OSHE-Github/RecycleBot/README.md

# OSHE-RecycleBot
<p align="middle">
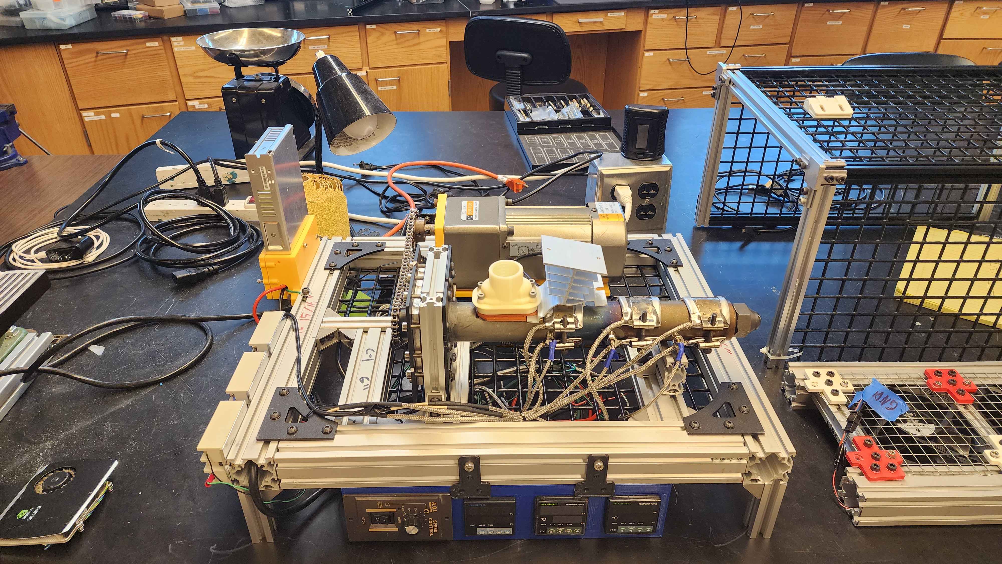
[picture p1: Pictures/Extruder.jpg]
  
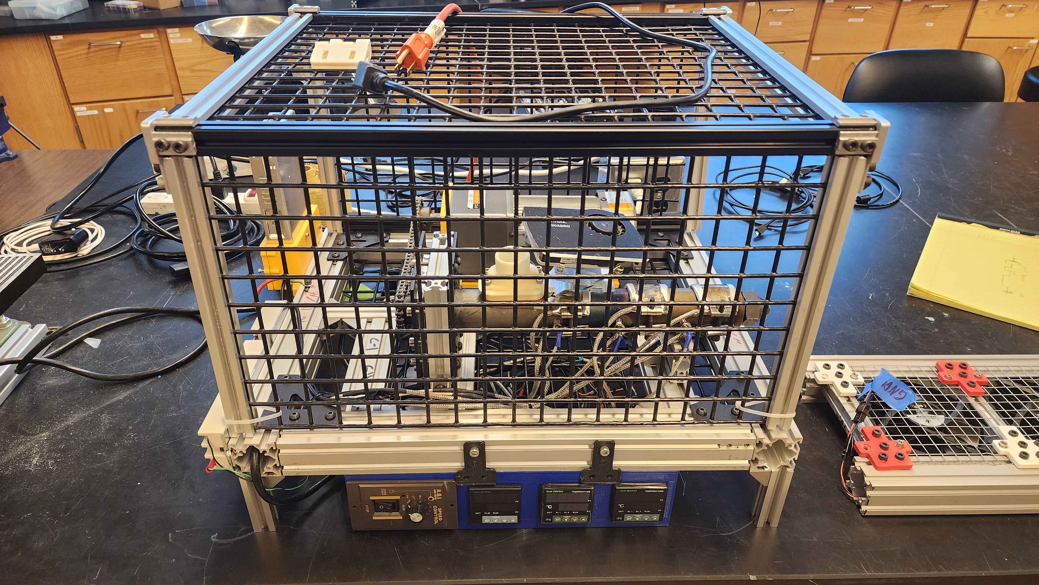
[picture p2: Pictures/Extruder-With-Frame.jpg]
  
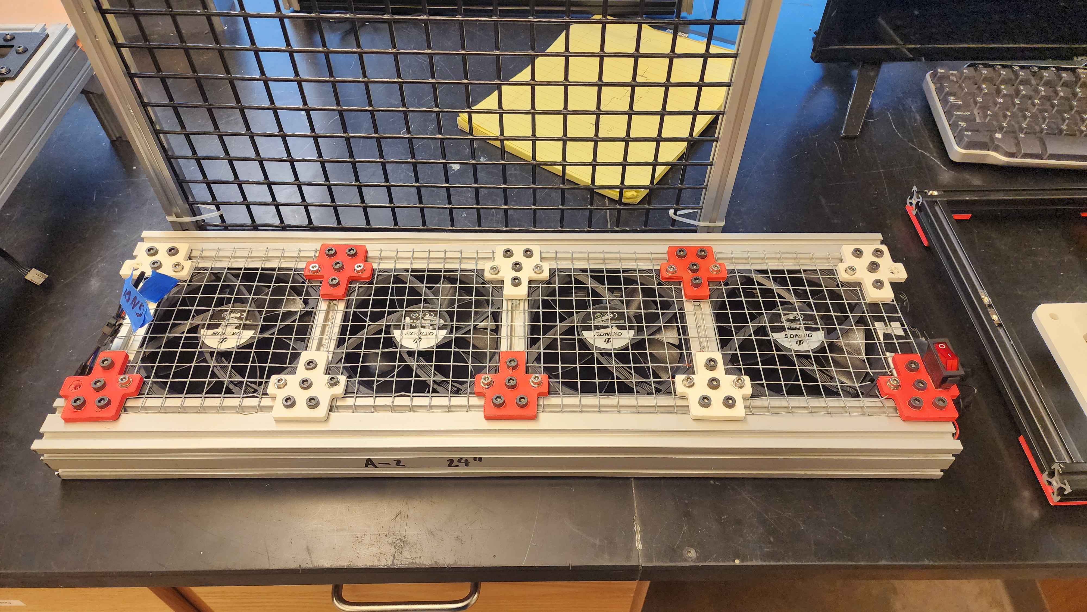
[picture p3: Pictures/Cooling.jpg]
  
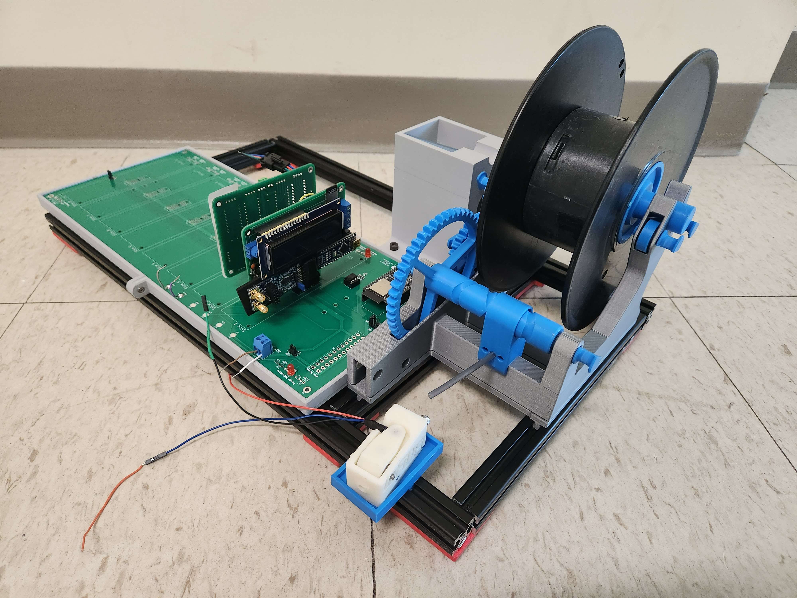
[picture p4: Pictures/Rewind.jpg]
  
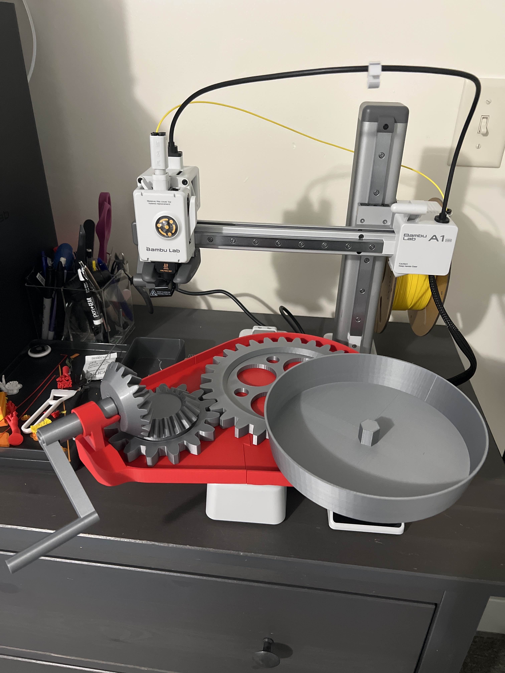
[picture p5: Pictures/Sieve.jpg]
  
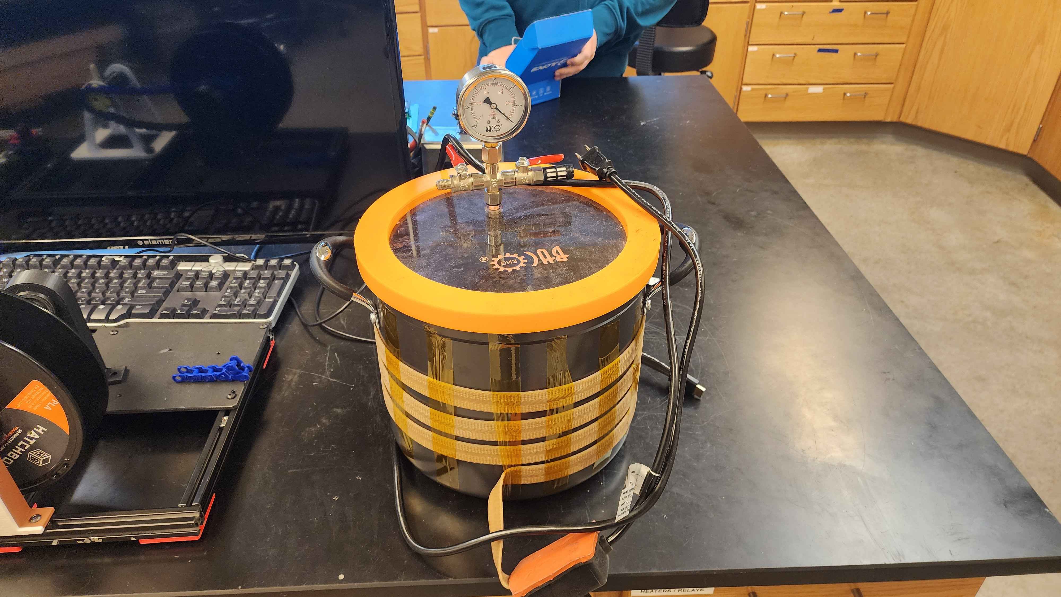
[picture p6: Pictures/Vacuum.jpg]
  
</p>
