OSHE-Github/RecycleBot/3D-Prints/Rewinder/Spool Stand/KYZ PASTA lite - Reducer Gear Fully Printed V2.stl.stl

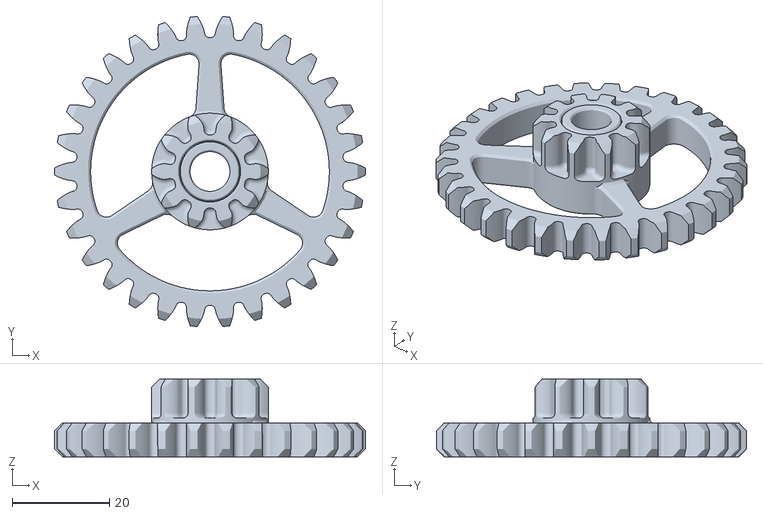
[picture p7: CAD file, 2025-04-26]
3D-Prints/Rewinder/Spool Stand/KYZ PASTA lite - Reducer Gear Fully Printed V2.stl.stl
64.0 x 63.8 x 16.0
