OSHE-Github/RecycleBot/3D-Prints/Rewinder/Spool Stand/KYZ PASTA lite - 608 Bearing Fully Printed.stl.stl

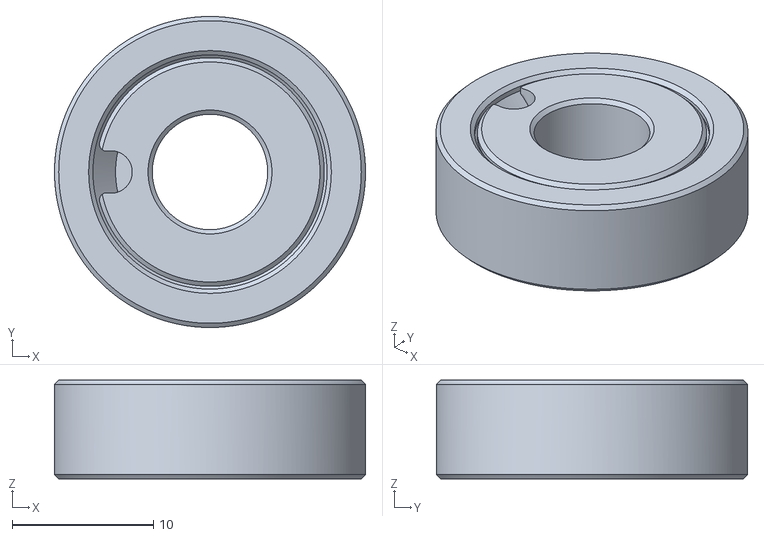
[picture p8: CAD file, 2025-04-26]
3D-Prints/Rewinder/Spool Stand/KYZ PASTA lite - 608 Bearing Fully Printed.stl.stl
22.0 x 22.0 x 7.00
