OSHE-Github/RecycleBot/3D-Prints/Rewinder/Spool Stand/KYZ PASTA lite - Idler Fully Printed v2.stl.stl

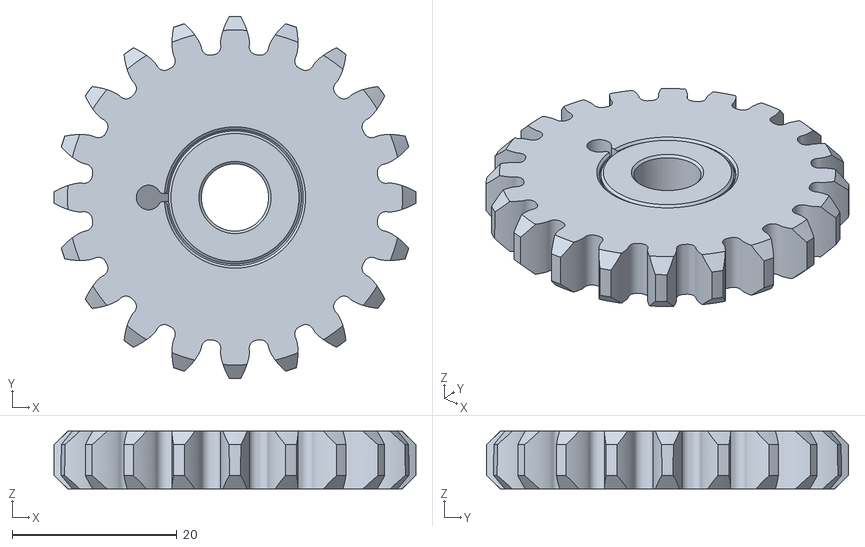
[picture p9: CAD file, 2025-04-26]
3D-Prints/Rewinder/Spool Stand/KYZ PASTA lite - Idler Fully Printed v2.stl.stl
44.0 x 44.0 x 7.00
