OSHE-Github/RecycleBot/3D-Prints/Extruder/Power Supply_Cover_x1.stl

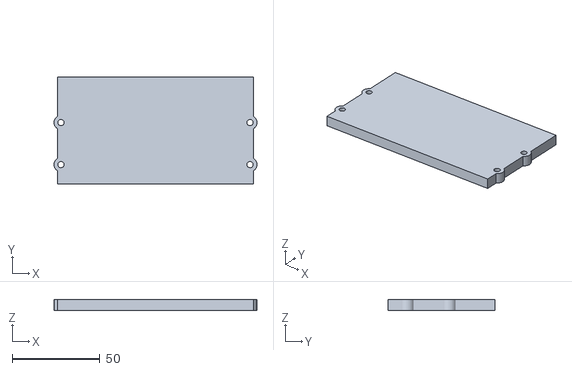
[picture p10: CAD file, 2025-04-26]
3D-Prints/Extruder/Power Supply_Cover_x1.stl
116.0 x 61.0 x 6.00
