OSHE-Github/RecycleBot/3D-Prints/Rewinder/DriveShaft.stl

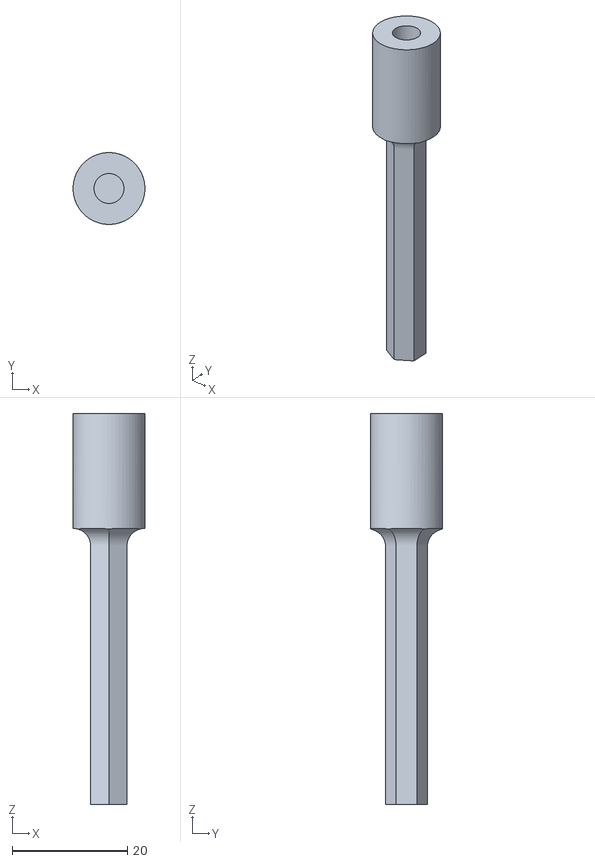
[picture p11: CAD file, 2025-04-26]
3D-Prints/Rewinder/DriveShaft.stl
12.5 x 12.5 x 68.0
