OSHE-Github/RecycleBot/3D-Prints/Rewinder/Spool Stand/KYZ PASTA lite - Spindle Front.stl.stl

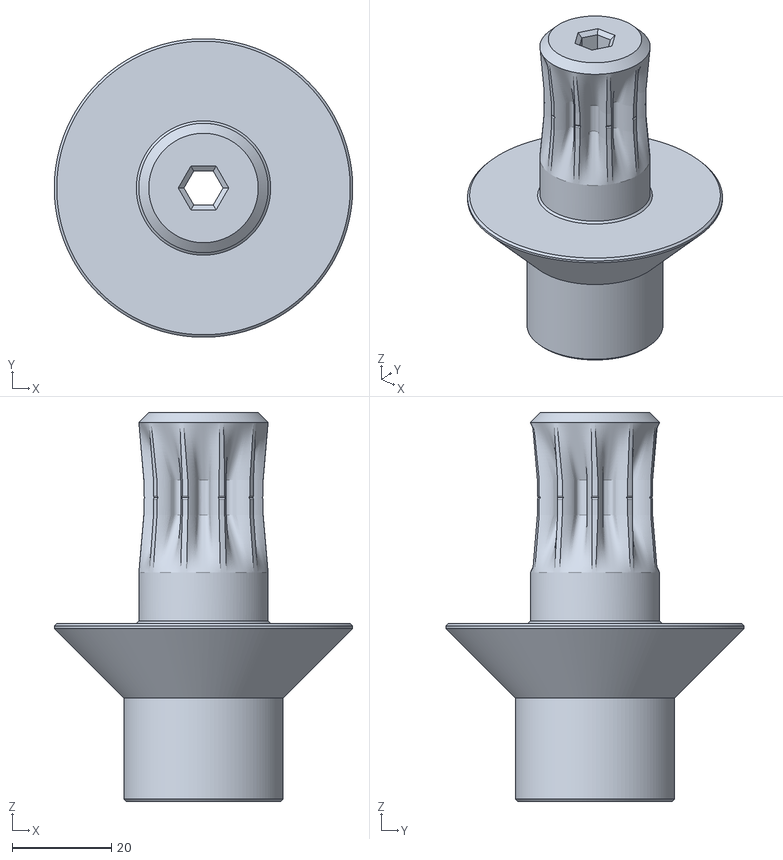
[picture p12: CAD file, 2025-04-26]
3D-Prints/Rewinder/Spool Stand/KYZ PASTA lite - Spindle Front.stl.stl
60.0 x 60.0 x 78.2
