OSHE-Github/RecycleBot/PCB/BREAD_DAQ/Parts/BC2032-E2.step

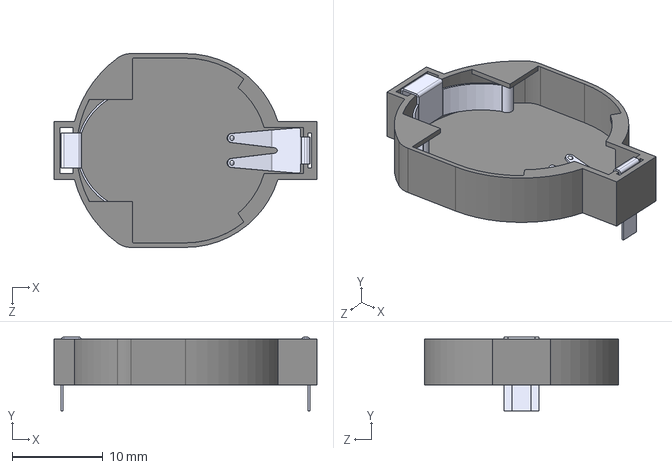
[picture p13: CAD file, 2025-03-17]
PCB/BREAD_DAQ/Parts/BC2032-E2.step
29.0 x 8.13 x 21.3 mm
