OSHE-Github/RecycleBot/PCB/BREAD_DAQ/Parts/CD74HC4050E/CD74HC4050E.step

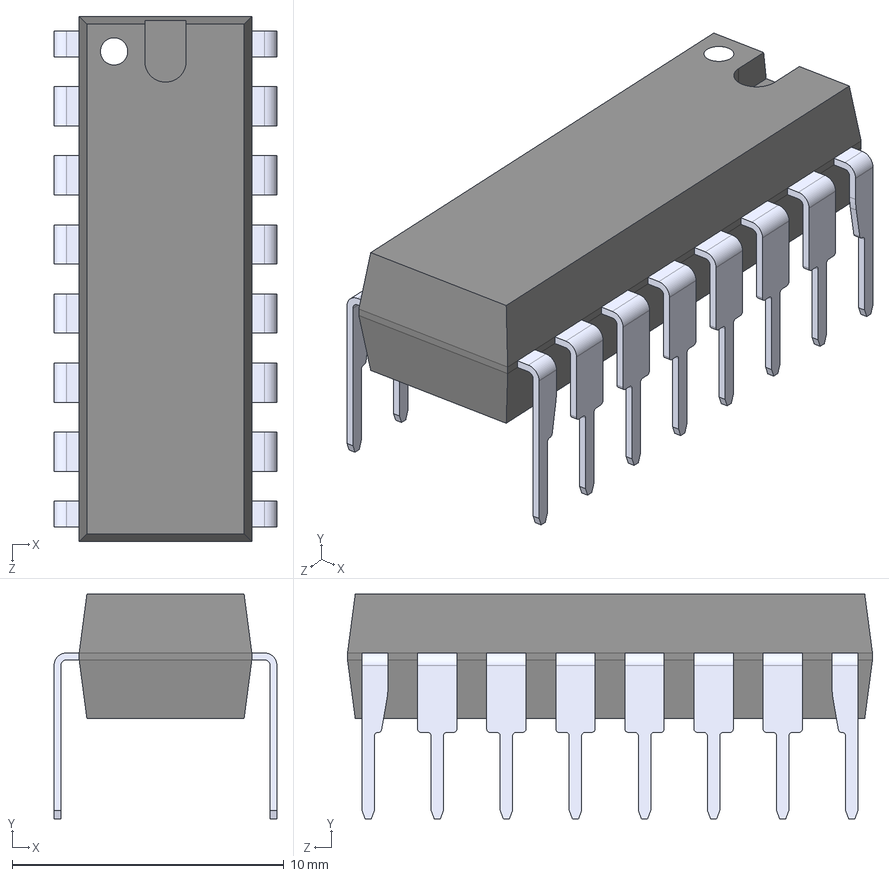
[picture p14: CAD file, 2025-03-17]
PCB/BREAD_DAQ/Parts/CD74HC4050E/CD74HC4050E.step
8.19 x 8.26 x 19.3 mm
