OSHE-Github/RecycleBot/PCB/BREAD_Slice_V2/Footprints/CC1206KKX5R8BB106/CERAMIC-10UF-25V-10_-X5R_1206_.step

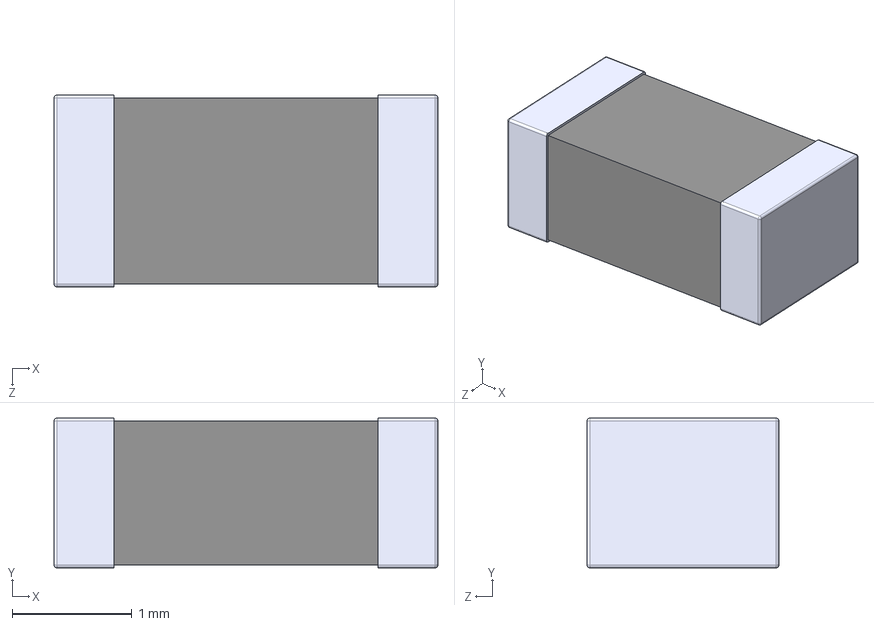
[picture p15: CAD file, 2025-03-17]
PCB/BREAD_Slice_V2/Footprints/CC1206KKX5R8BB106/CERAMIC-10UF-25V-10_-X5R_1206_.step
3.20 x 1.25 x 1.60 mm
