OSHE-Github/RecycleBot/PCB/BREAD_Slice_V2/Footprints/EEU_FC1H101/EEUFC1H101.step

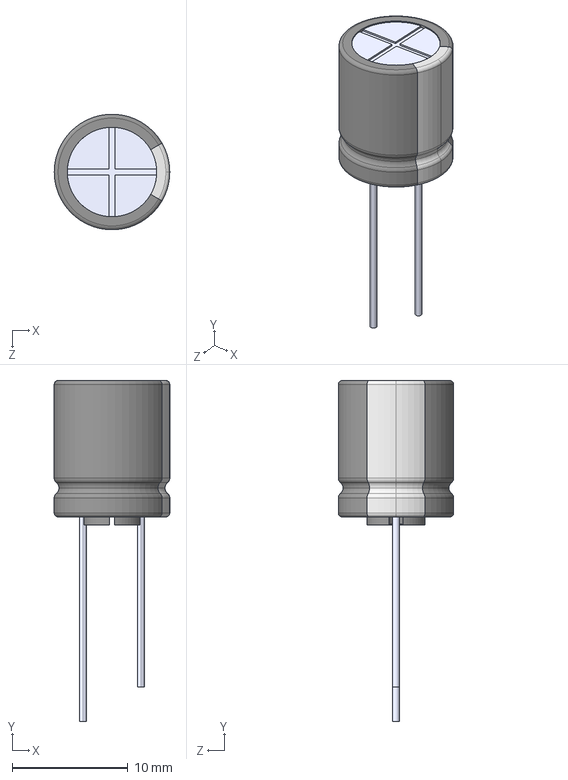
[picture p16: CAD file, 2025-03-17]
PCB/BREAD_Slice_V2/Footprints/EEU_FC1H101/EEUFC1H101.step
10.0 x 29.5 x 9.99 mm
