OSHE-Github/RecycleBot/3D-Prints/Extruder/Key.FCStd

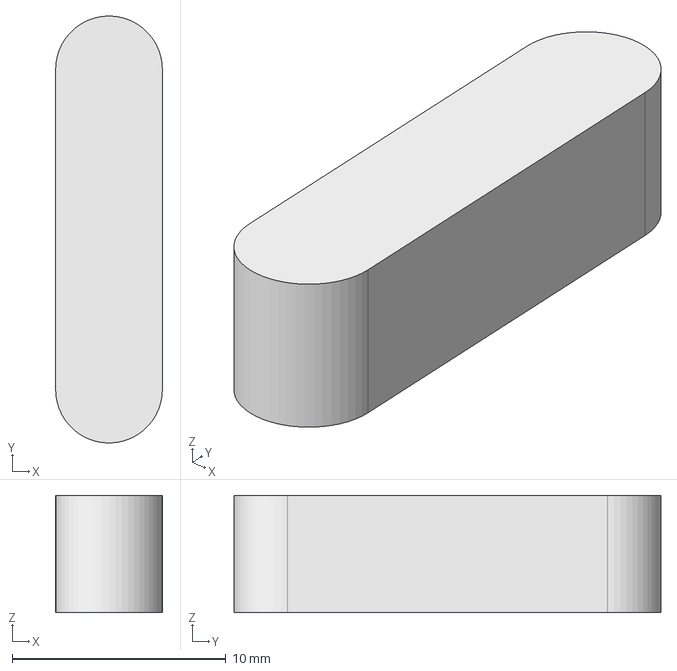
[picture p17: CAD file, 2025-04-26]
3D-Prints/Extruder/Key.FCStd
5.00 x 20.0 x 5.50 mm
