OSHE-Github/RecycleBot/3D-Prints/Rewinder/Rewind_Stand.stl

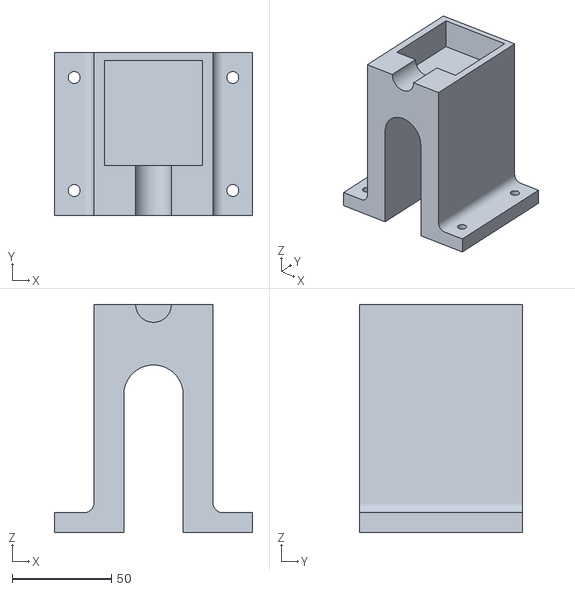
[picture p18: CAD file, 2025-04-26]
3D-Prints/Rewinder/Rewind_Stand.stl
100.0 x 82.0 x 115.0
