OSHE-Github/RecycleBot/3D-Prints/Rewinder/Spool Stand/KYZ PASTA lite - Guide Pin.stl.stl

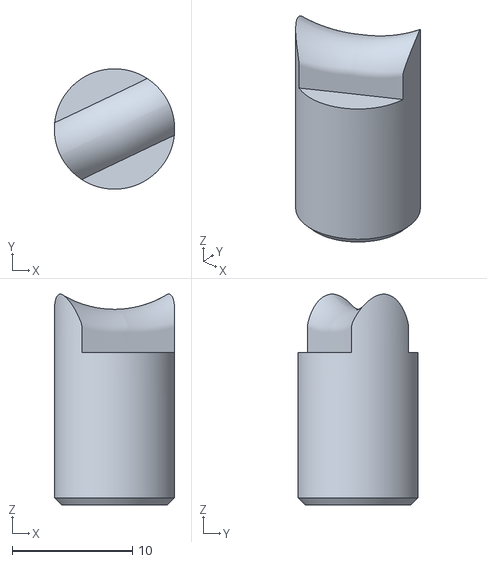
[picture p19: CAD file, 2025-04-26]
3D-Prints/Rewinder/Spool Stand/KYZ PASTA lite - Guide Pin.stl.stl
10.00 x 10.00 x 17.5
