OSHE-Github/RecycleBot/PCB/BREAD_DAQ/Parts/SOIC8-N_MC_MCH.iges

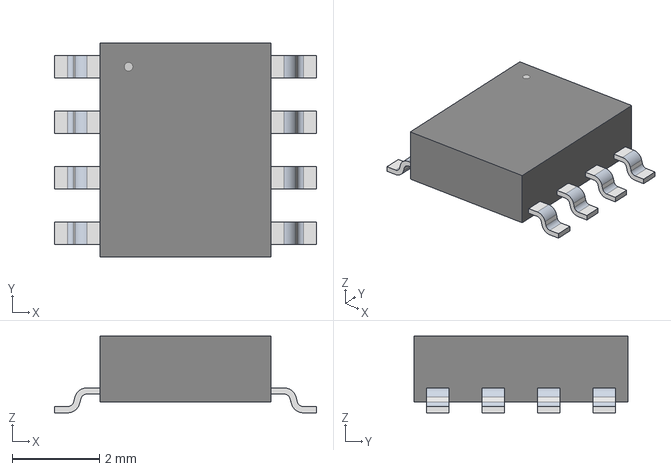
[picture p20: CAD file, 2025-03-17]
PCB/BREAD_DAQ/Parts/SOIC8-N_MC_MCH.iges
5.99 x 4.90 x 1.75 mm
