OSHE-Github/RecycleBot/3D-Prints/Extruder/Power Supply_Mount_x1.stl

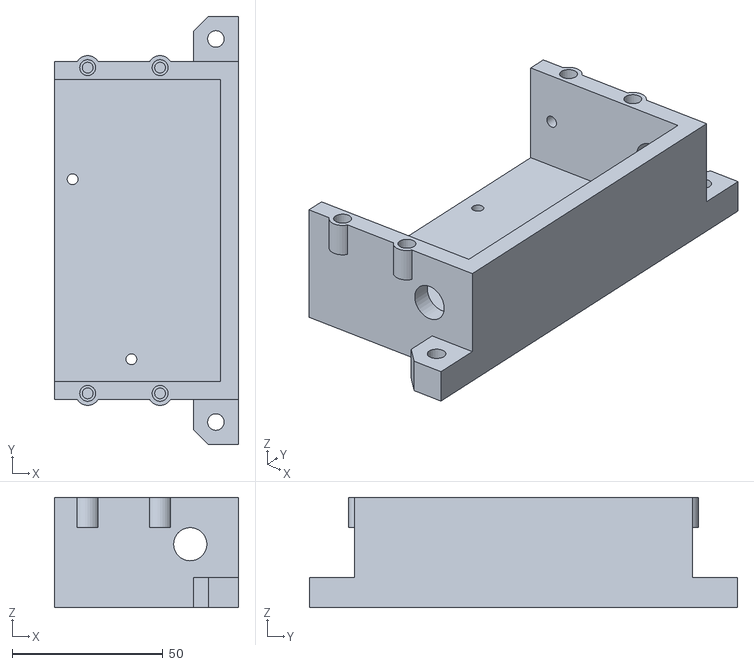
[picture p21: CAD file, 2025-04-26]
3D-Prints/Extruder/Power Supply_Mount_x1.stl
61.0 x 142.0 x 36.5
