OSHE-Github/RecycleBot/3D-Prints/Rewinder/Infidel_Stand.stl

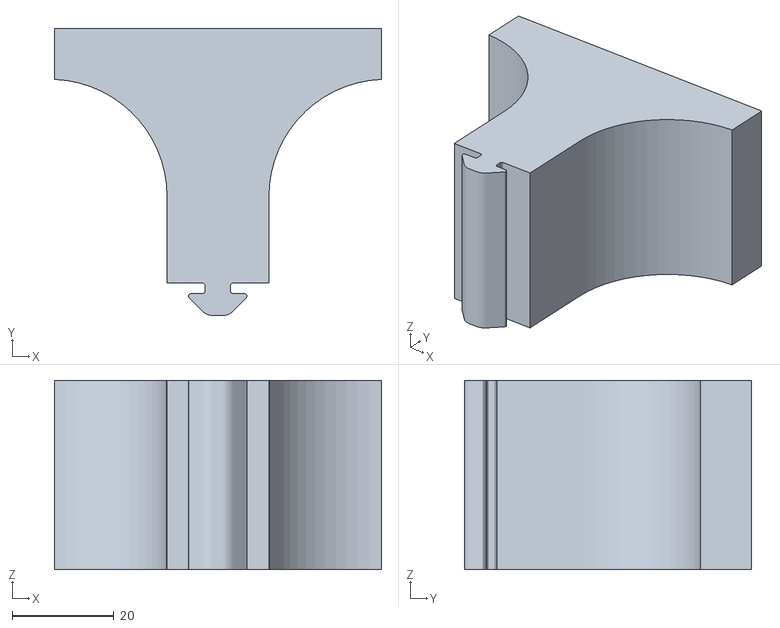
[picture p22: CAD file, 2025-04-26]
3D-Prints/Rewinder/Infidel_Stand.stl
64.2 x 56.4 x 37.2
