OSHE-Github/RecycleBot/3D-Prints/Extruder/MotorMount.FCStd

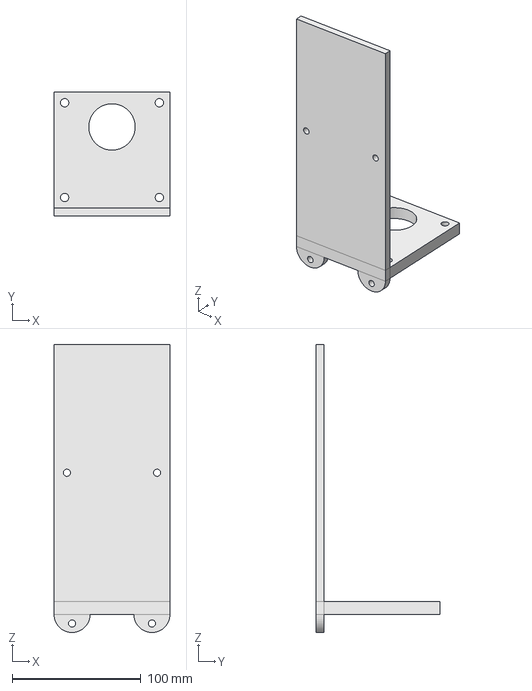
[picture p23: CAD file, 2025-04-26]
3D-Prints/Extruder/MotorMount.FCStd
90.0 x 96.0 x 223.6 mm
