OSHE-Github/RecycleBot/3D-Prints/Rewinder/Spool Stand/KYZ PASTA lite - Pin Short.stl.stl

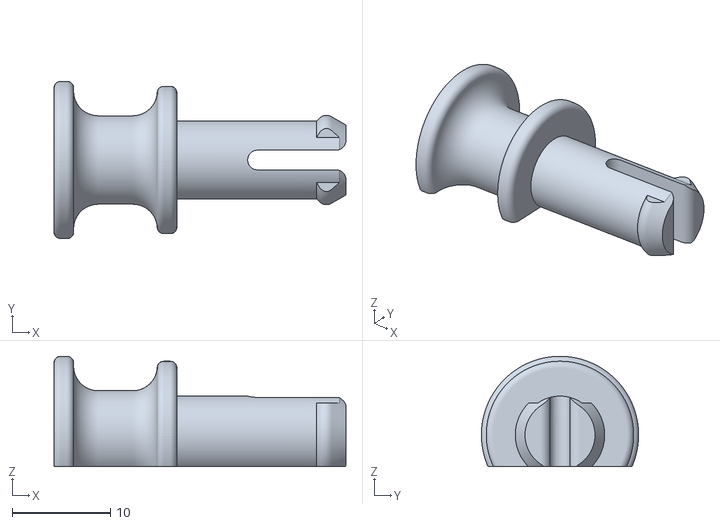
[picture p24: CAD file, 2025-04-26]
3D-Prints/Rewinder/Spool Stand/KYZ PASTA lite - Pin Short.stl.stl
29.7 x 16.0 x 11.2
