OSHE-Github/RecycleBot/3D-Prints/Rewinder/Spool Stand/KYZ+PASTA+lite+Receiver+v1.stl

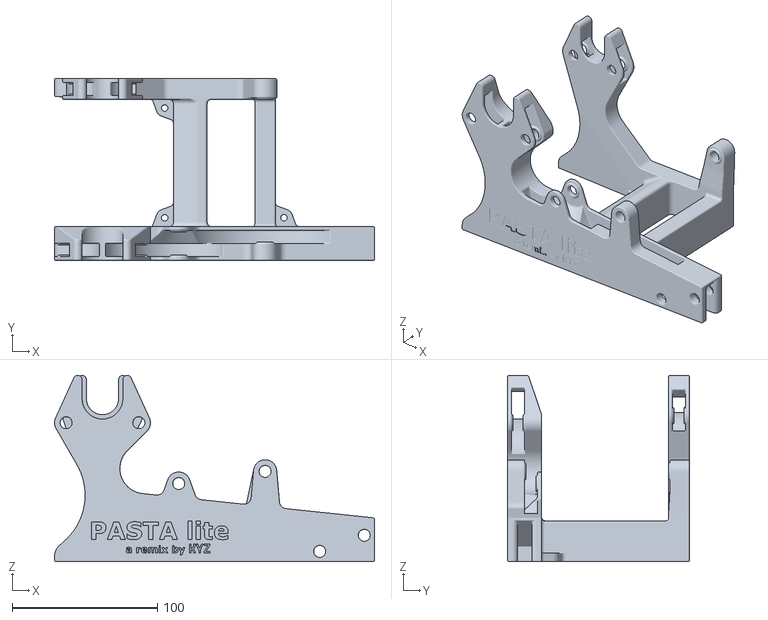
[picture p25: CAD file, 2025-04-26]
3D-Prints/Rewinder/Spool Stand/KYZ+PASTA+lite+Receiver+v1.stl
220.0 x 124.8 x 128.0
