OSHE-Github/RecycleBot/3D-Prints/Rewinder/Spool Stand/KYZ PASTA lite - Spindle Back.stl.stl

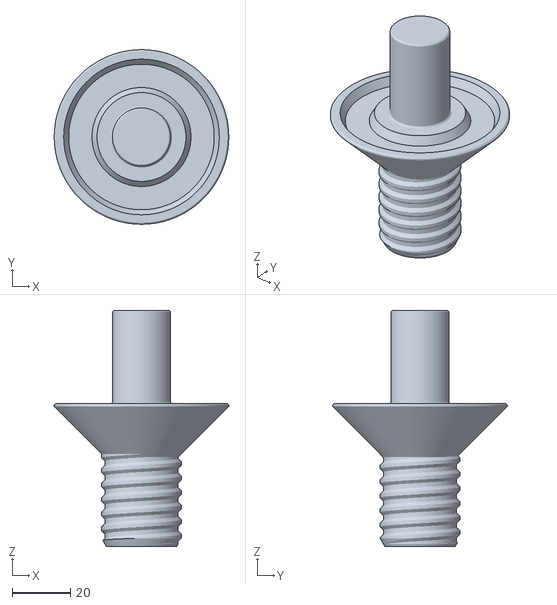
[picture p26: CAD file, 2025-04-26]
3D-Prints/Rewinder/Spool Stand/KYZ PASTA lite - Spindle Back.stl.stl
60.0 x 60.0 x 81.1
