OSHE-Github/RecycleBot/3D-Prints/Rewinder/Spool Stand/KYZ PASTA lite - Pin Long.stl.stl

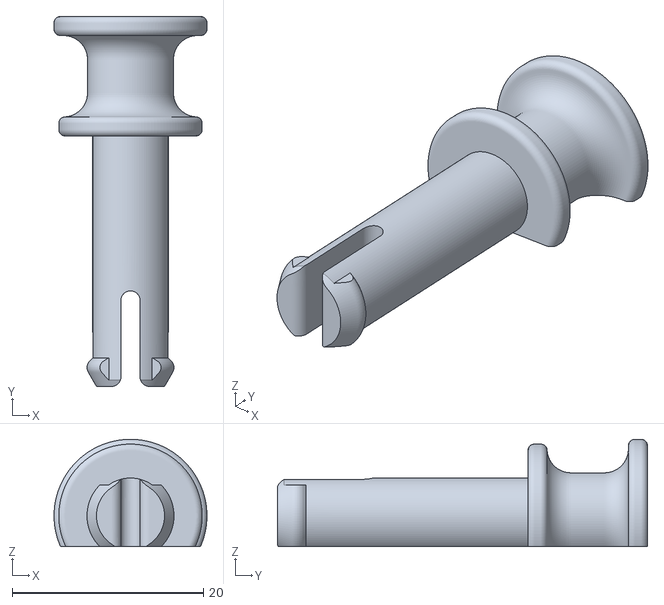
[picture p27: CAD file, 2025-04-26]
3D-Prints/Rewinder/Spool Stand/KYZ PASTA lite - Pin Long.stl.stl
16.0 x 38.7 x 11.2
