OSHE-Github/RecycleBot/3D-Prints/Rewinder/Spool Stand/KYZ PASTA lite - Guide Housing.stl.stl

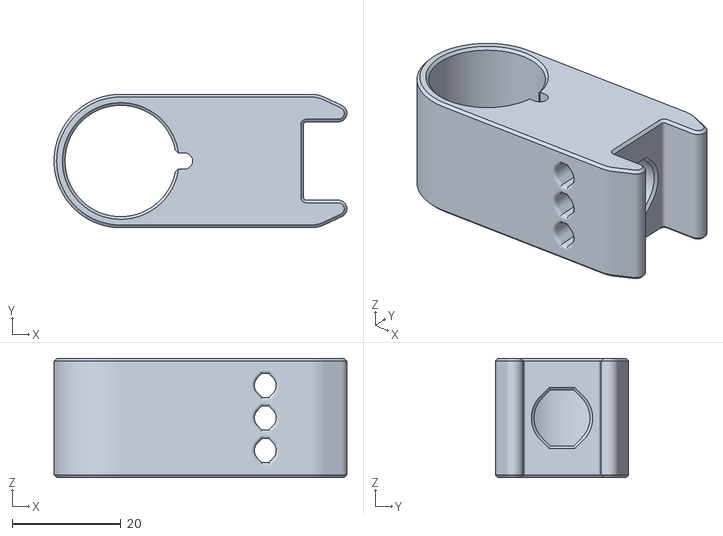
[picture p28: CAD file, 2025-04-26]
3D-Prints/Rewinder/Spool Stand/KYZ PASTA lite - Guide Housing.stl.stl
54.0 x 24.6 x 22.0
