OSHE-Github/RecycleBot/3D-Prints/Rewinder/Spool Stand/feet.stl

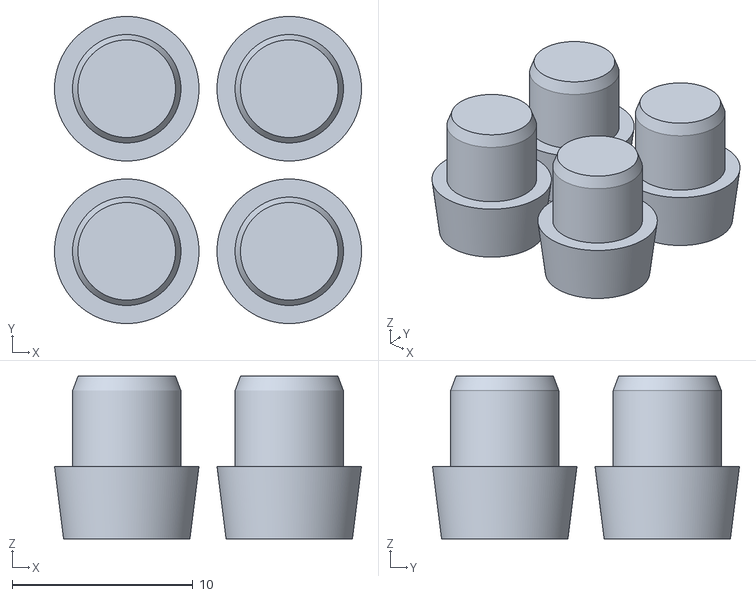
[picture p29: CAD file, 2025-04-26]
3D-Prints/Rewinder/Spool Stand/feet.stl
17.0 x 17.0 x 9.00
