OSHE-Github/RecycleBot/(list of files, cad)

Other CAD files:
3D-Prints/Rewinder/Spool Stand/KYZ PASTA lite - 608 Bearing Fully Printed.stl(1).stl
3D-Prints/Rewinder/Spool Stand/KYZ PASTA lite - Idler Fully Printed v2.stl(1).stl
3D-Prints/Rewinder/Spool Stand/KYZ PASTA lite - Lead Screw.stl.stl
3D-Prints/Rewinder/Spool Stand/KYZ PASTA lite - Pin Long.stl(1).stl
3D-Prints/Rewinder/Spool Stand/KYZ PASTA lite - Pin Long.stl(2).stl
3D-Prints/Rewinder/Spool Stand/KYZ PASTA lite - Pin Long.stl(3).stl
3D-Prints/Rewinder/Spool Stand/KYZ PASTA lite - Pin Long.stl(4).stl
3D-Prints/Rewinder/Spool Stand/KYZ PASTA lite - Pin Long.stl(5).stl
3D-Prints/Rewinder/Spool Stand/KYZ PASTA lite - Pin Long.stl(6).stl
3D-Prints/Rewinder/Spool Stand/KYZ PASTA lite - Pin Short.stl(1).stl
PCB/BREAD_Slice_V2/Footprints/10018783_10200TLF/10018783-10200TLF.step
