OSHE-Github/RecycleBot/3D-Prints/Extruder/Recycle Bot Wiring Diagram.png

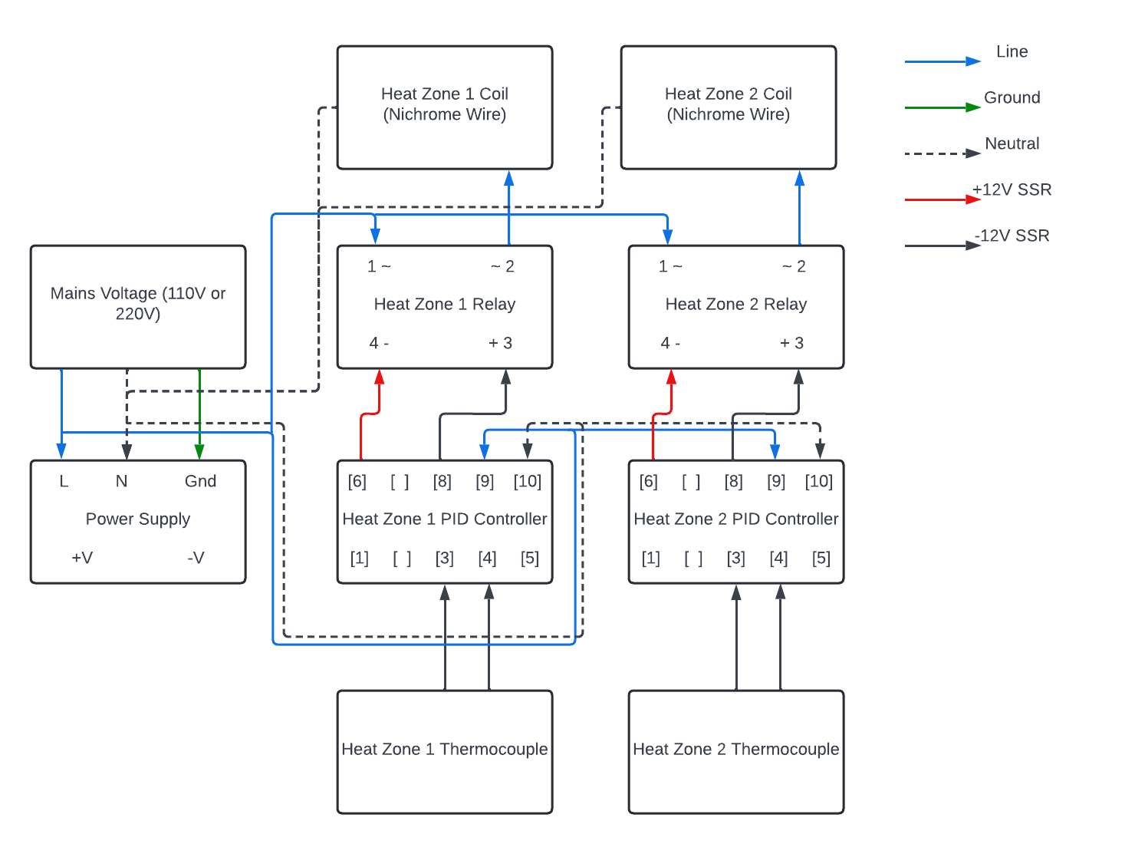
3D-Prints/Extruder/Recycle Bot Wiring Diagram.png
