OSHE-Github/RecycleBot/PCB/BREAD_Slice_V2/BREAD_slice_v2/BREAD_slice_v2.kicad_pcb

## KiCad design PCB/BREAD_Slice_V2/BREAD_slice_v2/BREAD_slice_v2.kicad_pcb (2025-03-31)

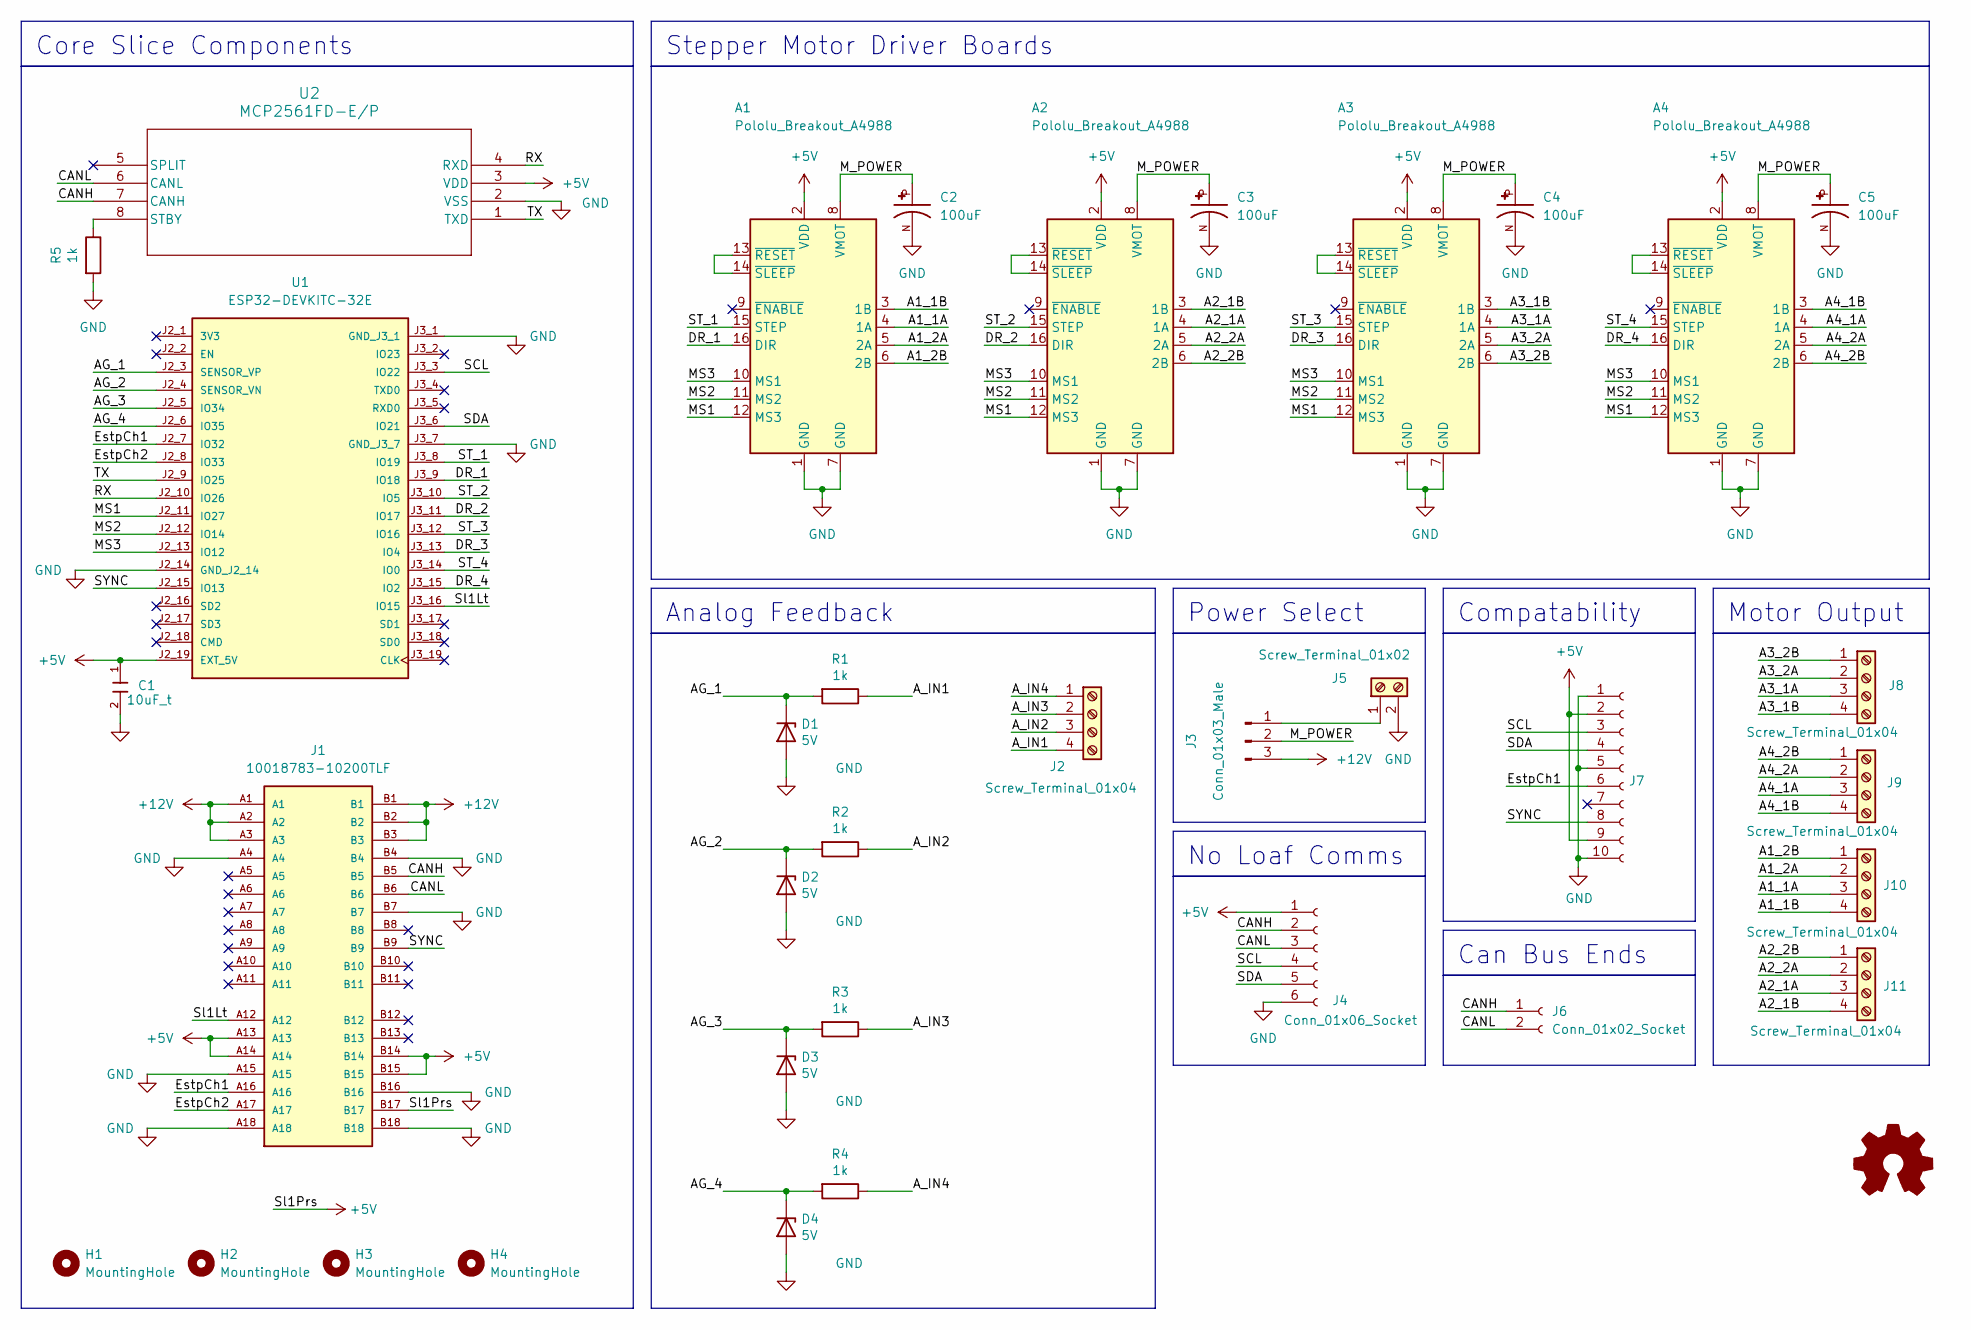
[picture p31: schematic BREAD_slice_v2.kicad_sch]

Parts:
A1, A2, A3, A4: Pololu_Breakout_A4988; Pololu_Breakout-16_15.2x20.3mm
C1: 10uF_t; C1206; Part # T491C106K025AT
C2, C3, C4, C5: 100uF; CAPPRD500W60D1000H1250; PARTREV 20-DEC-19
D1, D2, D3, D4: 5V; D_1206_3216Metric_Pad1.42x1.75mm_HandSolder
H1, H2, H3, H4: MountingHole; MountingHole_3.2mm_M3_DIN965_Pad
J1: 10018783-10200TLF; BUS_PCIexpress_x1; PARTREV Z
J2, J8, J9, J10, J11: Screw_Terminal_01x04; TerminalBlock_TE_282834-4_1x04_P2.54mm_Horizontal
J3: Conn_01x03_Male; PinSocket_1x03_P2.54mm_Vertical
J4: Conn_01x06_Socket; PinSocket_1x06_P2.54mm_Horizontal
J5: Screw_Terminal_01x02; TerminalBlock_TE_282834-2_1x02_P2.54mm_Horizontal
J6: Conn_01x02_Socket; PinSocket_1x02_P2.54mm_Vertical
J7: Conn_01x10_Socket; PinSocket_1x10_P2.54mm_Horizontal
Logo1: Logo_Open_Hardware_Small; OSHW-Symbol_6.7x6mm_SilkScreen
R1, R2, R3, R4, R5: 1k; R_1206_3216Metric_Pad1.30x1.75mm_HandSolder
U1: ESP32-DEVKITC-32E; MODULE_ESP32-DEVKITC-32E; PARTREV 1.4
U2: MCP2561FD-E/P; PDIP8_300MC_MCH

Connections:
+5V: A1.2 (VDD), A2.2 (VDD), A3.2 (VDD), A4.2 (VDD), C1.1, J1.A13, J1.A14, J1.B14, J1.B15, J1.B17, J4.1, J7.2, J7.9, U1.J2_19 (EXT_5V), U2.3 (VDD)
+12V: J1.A1, J1.A2, J1.A3, J1.B1, J1.B2, J1.B3, J3.3
/A1_1A: A1.4 (1A), J10.3
/A1_1B: A1.3 (1B), J10.4
/A1_2A: A1.5 (2A), J10.2
/A1_2B: A1.6 (2B), J10.1
/A2_1A: A2.4 (1A), J11.3
/A2_1B: A2.3 (1B), J11.4
/A2_2A: A2.5 (2A), J11.2
/A2_2B: A2.6 (2B), J11.1
/A3_1A: A3.4 (1A), J8.3
/A3_1B: A3.3 (1B), J8.4
/A3_2A: A3.5 (2A), J8.2
/A3_2B: A3.6 (2B), J8.1
/A4_1A: A4.4 (1A), J9.3
/A4_1B: A4.3 (1B), J9.4
/A4_2A: A4.5 (2A), J9.2
/A4_2B: A4.6 (2B), J9.1
/AG_1: D1.1 (K), R1.2, U1.J2_3 (SENSOR_VP)
/AG_2: D2.1 (K), R2.2, U1.J2_4 (SENSOR_VN)
/AG_3: D3.1 (K), R3.2, U1.J2_5 (IO34)
/AG_4: D4.1 (K), R4.2, U1.J2_6 (IO35)
/A_IN1: J2.4, R1.1
/A_IN2: J2.3, R2.1
/A_IN3: J2.2, R3.1
/A_IN4: J2.1, R4.1
/CANH: J1.B5, J4.2, J6.1, U2.7 (CANH)
/CANL: J1.B6, J4.3, J6.2, U2.6 (CANL)
/DR_1: A1.16 (DIR), U1.J3_9 (IO18)
/DR_2: A2.16 (DIR), U1.J3_11 (IO17)
/DR_3: A3.16 (DIR), U1.J3_13 (IO4)
/DR_4: A4.16 (DIR), U1.J3_15 (IO2)
/EstpCh1: J1.A16, J7.6, U1.J2_7 (IO32)
/EstpCh2: J1.A17, U1.J2_8 (IO33)
/MS1: A1.12 (MS3), A2.12 (MS3), A3.12 (MS3), A4.12 (MS3), U1.J2_11 (IO27)
/MS2: A1.11 (MS2), A2.11 (MS2), A3.11 (MS2), A4.11 (MS2), U1.J2_12 (IO14)
/MS3: A1.10 (MS1), A2.10 (MS1), A3.10 (MS1), A4.10 (MS1), U1.J2_13 (IO12)
/M_POWER: A1.8 (VMOT), A2.8 (VMOT), A3.8 (VMOT), A4.8 (VMOT), C2.P, C3.P, C4.P, C5.P, J3.2
/RX: U1.J2_10 (IO26), U2.4 (RXD)
/SCL: J4.4, J7.3, U1.J3_3 (IO22)
/SDA: J4.5, J7.4, U1.J3_6 (IO21)
/ST_1: A1.15 (STEP), U1.J3_8 (IO19)
/ST_2: A2.15 (STEP), U1.J3_10 (IO5)
/ST_3: A3.15 (STEP), U1.J3_12 (IO16)
/ST_4: A4.15 (STEP), U1.J3_14 (IO0)
/SYNC: J1.B9, J7.8, U1.J2_15 (IO13)
/Sl1Lt: J1.A12, U1.J3_16 (IO15)
/TX: U1.J2_9 (IO25), U2.1 (TXD)
GND: A1.1 (GND), A1.7 (GND), A2.1 (GND), A2.7 (GND), A3.1 (GND), A3.7 (GND), A4.1 (GND), A4.7 (GND), C1.2, C2.N, C3.N, C4.N, C5.N, D1.2 (A), D2.2 (A), D3.2 (A), D4.2 (A), J1.A4, J1.A15, J1.A18, J1.B4, J1.B7, J1.B16, J1.B18, J4.6, J5.2, J7.1, J7.5, J7.10, R5.2, U1.J2_14 (GND_J2_14), U1.J3_1 (GND_J3_1), U1.J3_7 (GND_J3_7), U2.2 (VSS)
unnamed: A1.13 (~RESET), A1.14 (~SLEEP)
unnamed: A2.13 (~RESET), A2.14 (~SLEEP)
unnamed: A3.13 (~RESET), A3.14 (~SLEEP)
unnamed: A4.13 (~RESET), A4.14 (~SLEEP)
unnamed: J3.1, J5.1
unnamed: R5.1, U2.8 (STBY)

Notes on the sheet:
Analog Feedback
Compatability
Stepper Motor Driver Boards
Can Bus Ends
Motor Output
Power Select
Core Slice Components
No Loaf Comms

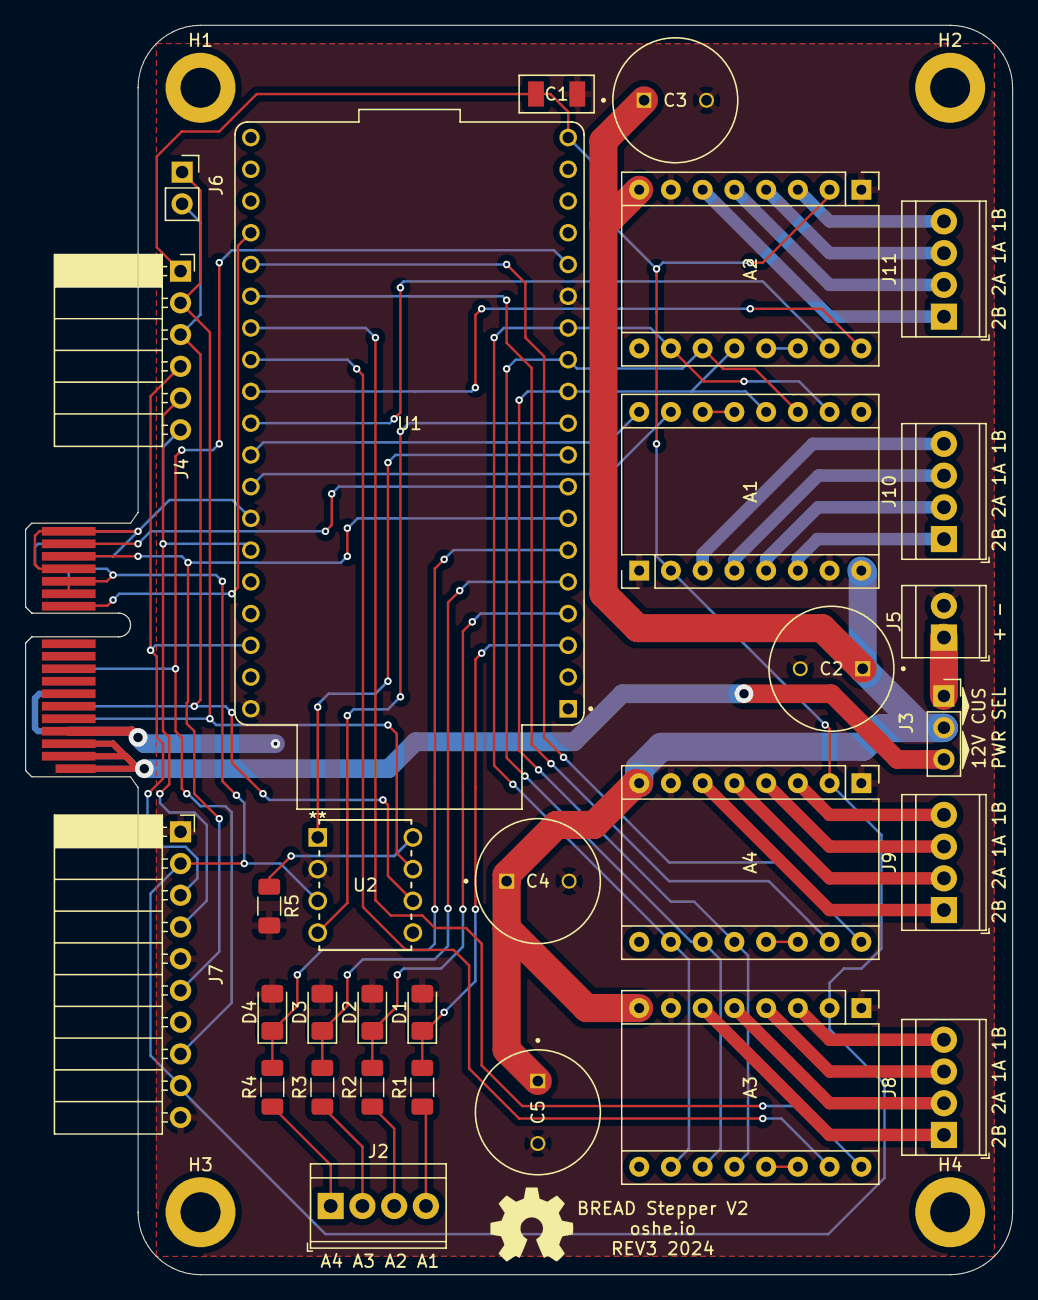
[picture p32: board BREAD_slice_v2.kicad_pcb from above]

Board: 2 copper layers, 79.0 x 100.0 mm, 36 parts (1 on the bottom side), 55 nets.
