OSHE-Github/RecycleBot/PCB/BREAD_DAQ/DAQ Rev 2.kicad_pcb

## KiCad design PCB/BREAD_DAQ/DAQ Rev 2.kicad_pcb (2025-03-17)

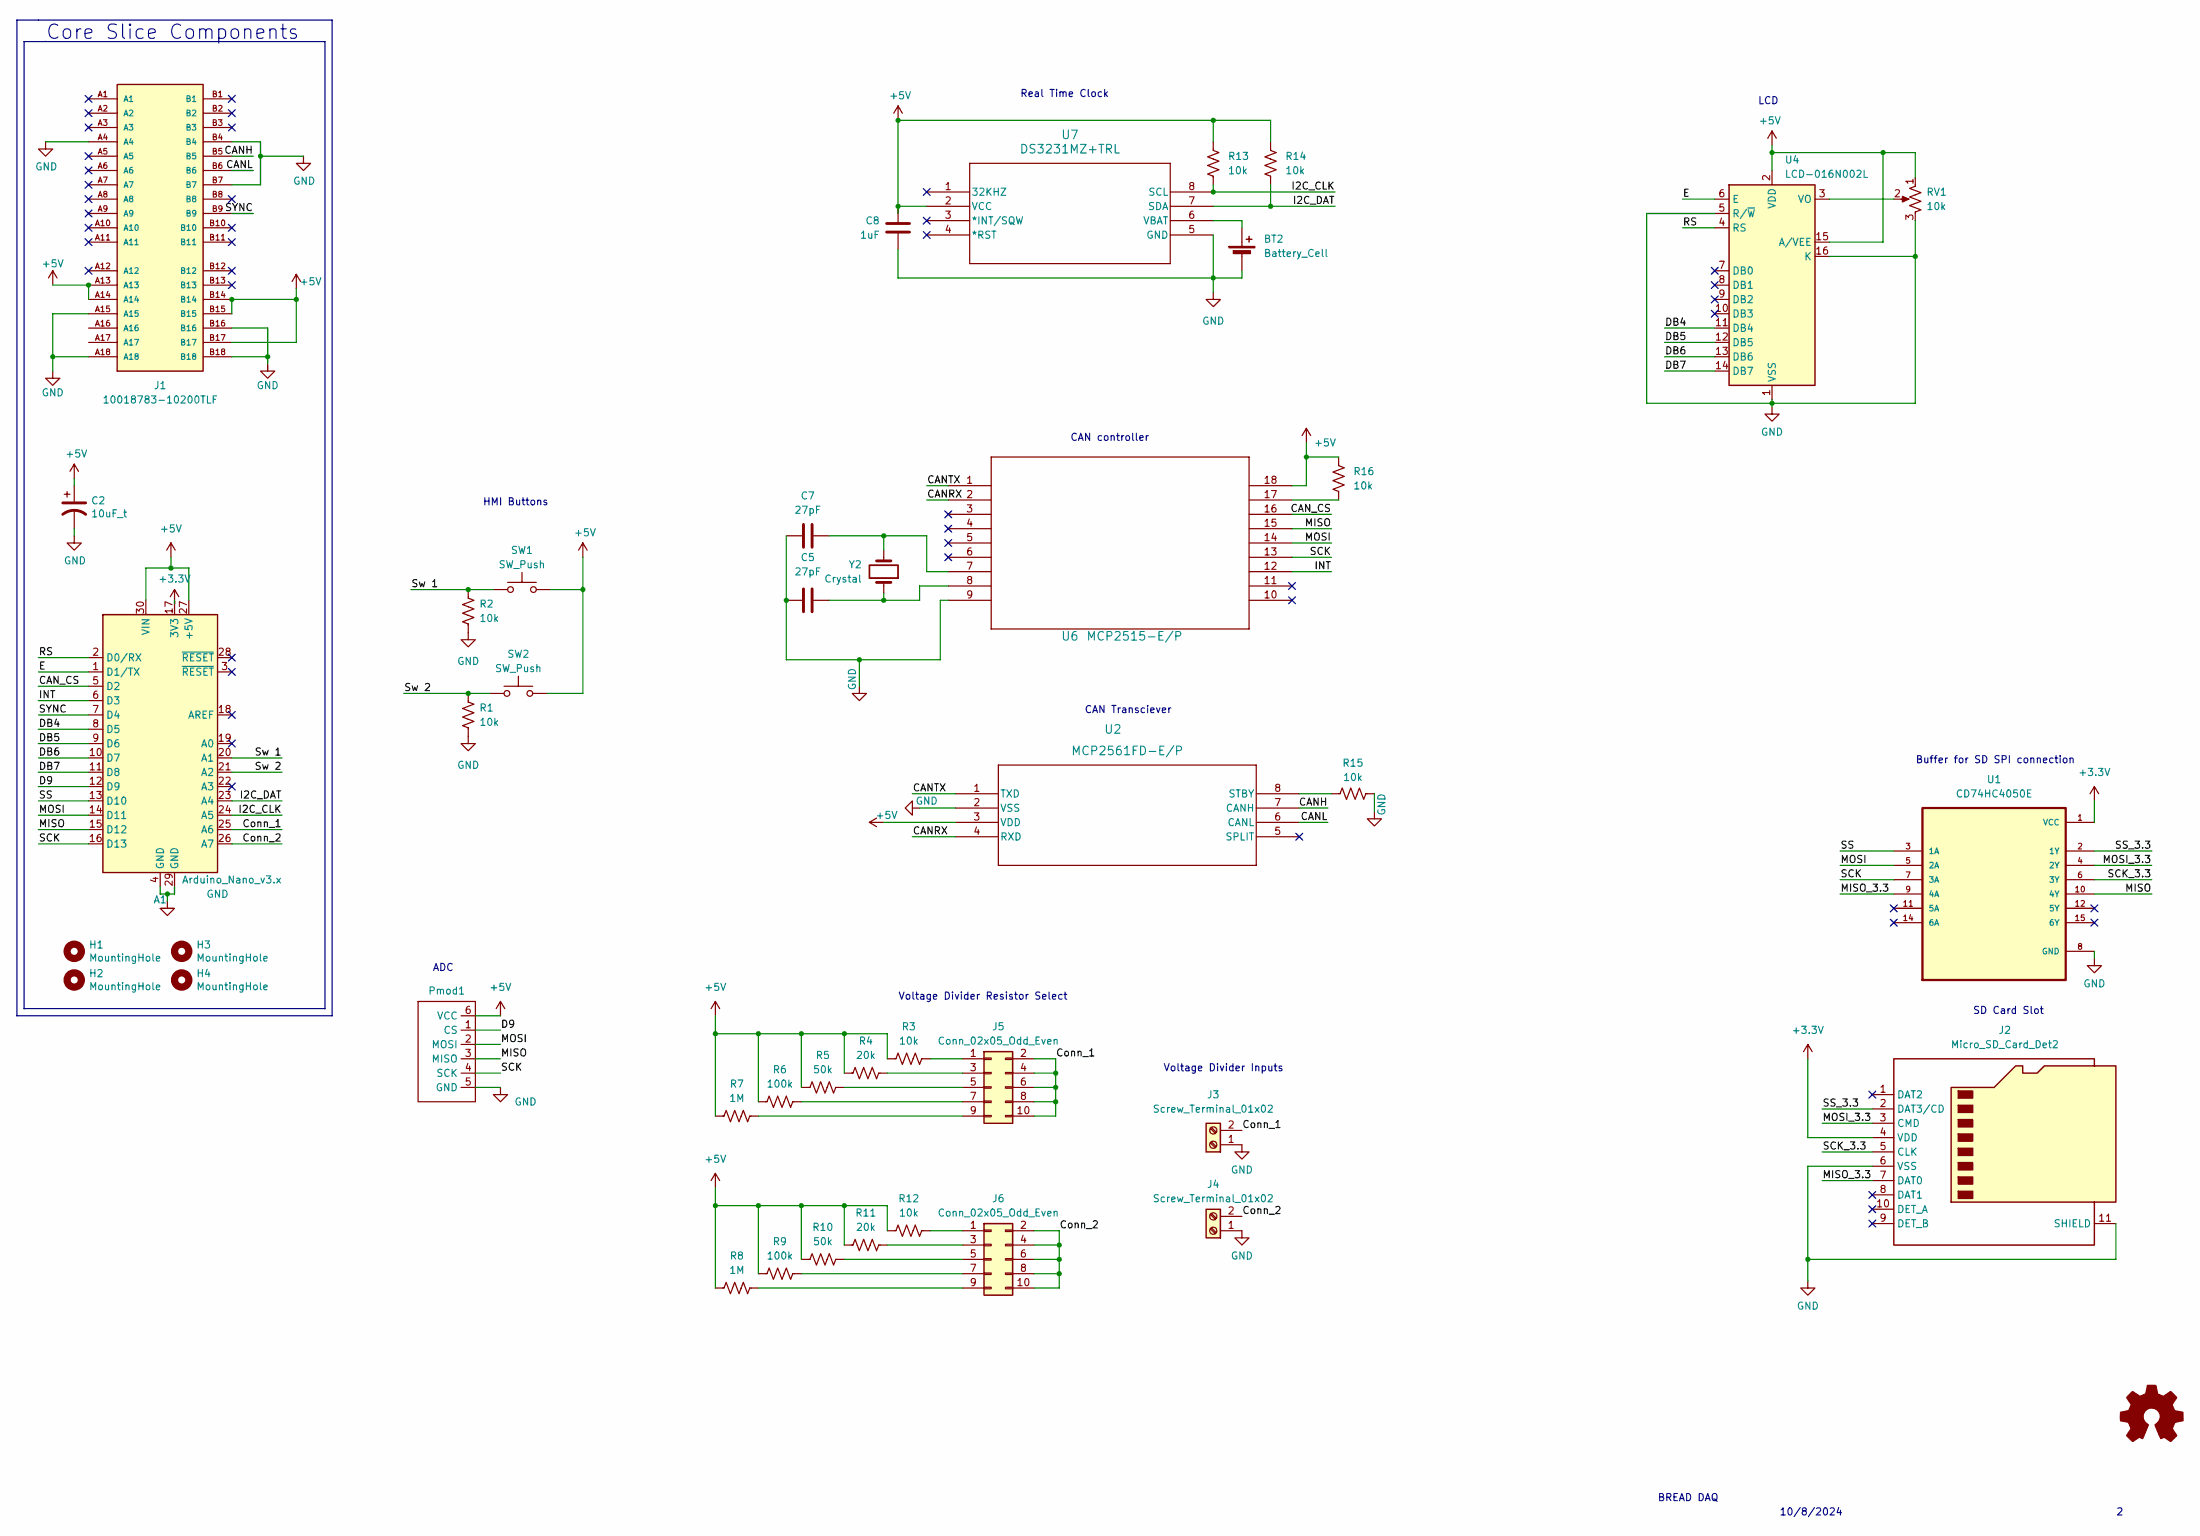
[picture p33: schematic DAQ Rev 2.kicad_sch]

Parts:
A1: Arduino_Nano_v3.x; Arduino_Nano
BT2: Battery_Cell; BatteryHolder_Keystone_3034_1x20mm
C2: 10uF_t; C_1206_3216Metric_Pad1.33x1.80mm_HandSolder; Part # T491C106K025AT
C5, C7: 27pF; C_1206_3216Metric_Pad1.33x1.80mm_HandSolder
C8: 1uF; C_1206_3216Metric_Pad1.33x1.80mm_HandSolder
H1, H2, H3, H4: MountingHole; MountingHole_3.2mm_M3_DIN965_Pad
J1: 10018783-10200TLF; BUS_PCIexpress_x1; PARTREV Z
J2: Micro_SD_Card_Det2; 104031-0811_MOL
J3, J4: Screw_Terminal_01x02; TerminalBlock_Phoenix_MKDS-1,5-2_1x02_P5.00mm_Horizontal
J5, J6: Conn_02x05_Odd_Even; PinHeader_2x05_P2.54mm_Vertical
Logo1: Logo_Open_Hardware_Small; OSHW-Symbol_6.7x6mm_SilkScreen
Pmod1: PinSocket_1x06_P2.54mm_Horizontal
R1, R2, R3, R12, R13, R14, R15, R16: 10k; R_1206_3216Metric_Pad1.30x1.75mm_HandSolder
R4, R11: 20k; R_1206_3216Metric_Pad1.30x1.75mm_HandSolder
R5, R10: 50k; R_1206_3216Metric_Pad1.30x1.75mm_HandSolder
R6, R9: 100k; R_1206_3216Metric_Pad1.30x1.75mm_HandSolder
R7, R8: 1M; R_1206_3216Metric_Pad1.30x1.75mm_HandSolder
RV1: 10k; Potentiometer_Bourns_3386P_Vertical
SW1, SW2: SW_Push; SW_PUSH_6mm
U1: CD74HC4050E; DIP794W45P254L1969H508Q16
U2: MCP2561FD-E/P; PDIP8_300MC_MCH
U4: LCD-016N002L; WC1602A-No holes
U6: MCP2515-E/P; PDIP18_300MC_MCH
U7: DS3231MZ+TRL; 21-0041B_8_MXM
Y2: Crystal; XTAL_ECS-160-20-3X-TR

Connections:
+3.3V: A1.17 (3V3), J2.4 (VDD), U1.1 (VCC)
+5V: A1.27 (+5V), A1.30 (VIN), C2.1, C8.1, J1.A13, J1.A14, J1.B14, J1.B15, J1.B17, Pmod1.6 (VCC), R3.2, R4.2, R5.2, R6.2, R7.2, R8.2, R9.2, R10.2, R11.2, R12.2, R13.1, R14.1, R16.2, RV1.1, SW1.2, SW2.2, U2.3 (VDD), U4.2 (VDD), U4.15 (A/VEE), U6.18, U7.2 (VCC)
/CANH: J1.B5, U2.7 (CANH)
/CANL: J1.B6, U2.6 (CANL)
/CANRX: U2.4 (RXD), U6.2
/CANTX: U2.1 (TXD), U6.1
/CAN_CS: A1.5 (D2), U6.16
/Conn_1: A1.25 (A6), J3.2, J5.2, J5.4, J5.6, J5.8, J5.10
/Conn_2: A1.26 (A7), J4.2, J6.2, J6.4, J6.6, J6.8, J6.10
/D9: A1.12 (D9), Pmod1.1 (CS)
/DB4: A1.8 (D5), U4.11 (DB4)
/DB5: A1.9 (D6), U4.12 (DB5)
/DB6: A1.10 (D7), U4.13 (DB6)
/DB7: A1.11 (D8), U4.14 (DB7)
/E: A1.1 (D1/TX), U4.6 (E)
/I2C_CLK: A1.24 (A5), R13.2, U7.8 (SCL)
/I2C_DAT: A1.23 (A4), R14.2, U7.7 (SDA)
/INT: A1.6 (D3), U6.12
/MISO: A1.15 (D12), Pmod1.3 (MISO), U1.10 (4Y), U6.15
/MISO_3.3: J2.7 (DAT0), U1.9 (4A)
/MOSI: A1.14 (D11), Pmod1.2 (MOSI), U1.5 (2A), U6.14
/MOSI_3.3: J2.3 (CMD), U1.4 (2Y)
/RS: A1.2 (D0/RX), U4.4 (RS)
/SCK: A1.16 (D13), Pmod1.4 (SCK), U1.7 (3A), U6.13
/SCK_3.3: J2.5 (CLK), U1.6 (3Y)
/SS: A1.13 (D10), U1.3 (1A)
/SS_3.3: J2.2 (DAT3/CD), U1.2 (1Y)
/SYNC: A1.7 (D4), J1.B9
/Sw 1: A1.20 (A1), R2.2, SW1.1
/Sw 2: A1.21 (A2), R1.2, SW2.1
GND: A1.4 (GND), A1.29 (GND), BT2.2 (-), C2.2, C5.2, C7.1, C8.2, J1.A4, J1.A15, J1.A18, J1.B4, J1.B7, J1.B16, J1.B18, J2.6 (VSS), J2.11 (SHIELD), J3.1, J4.1, Pmod1.5 (GND), R1.1, R2.1, R15.1, RV1.3, U1.8 (GND), U2.2 (VSS), U4.1 (VSS), U4.5 (R/~W), U4.16 (K), U6.9, U7.5 (GND)
unnamed: BT2.1 (+), U7.6 (VBAT)
unnamed: C5.1, U6.8, Y2.1
unnamed: C7.2, U6.7, Y2.2
unnamed: J5.1, R3.1
unnamed: J5.3, R4.1
unnamed: J5.5, R5.1
unnamed: J5.7, R6.1
unnamed: J5.9, R7.1
unnamed: J6.1, R12.1
unnamed: J6.3, R11.1
unnamed: J6.5, R10.1
unnamed: J6.7, R9.1
unnamed: J6.9, R8.1
unnamed: R16.1, U6.17
unnamed: R15.2, U2.8 (STBY)
unnamed: RV1.2, U4.3 (VO)

Notes on the sheet:
Real Time Clock
HMI Buttons
ADC
Voltage Divider Inputs
10/8/2024
BREAD DAQ
Buffer for SD SPI connection
Core Slice Components
CAN Transciever
Voltage Divider Resistor Select
SD Card Slot
LCD
CAN controller

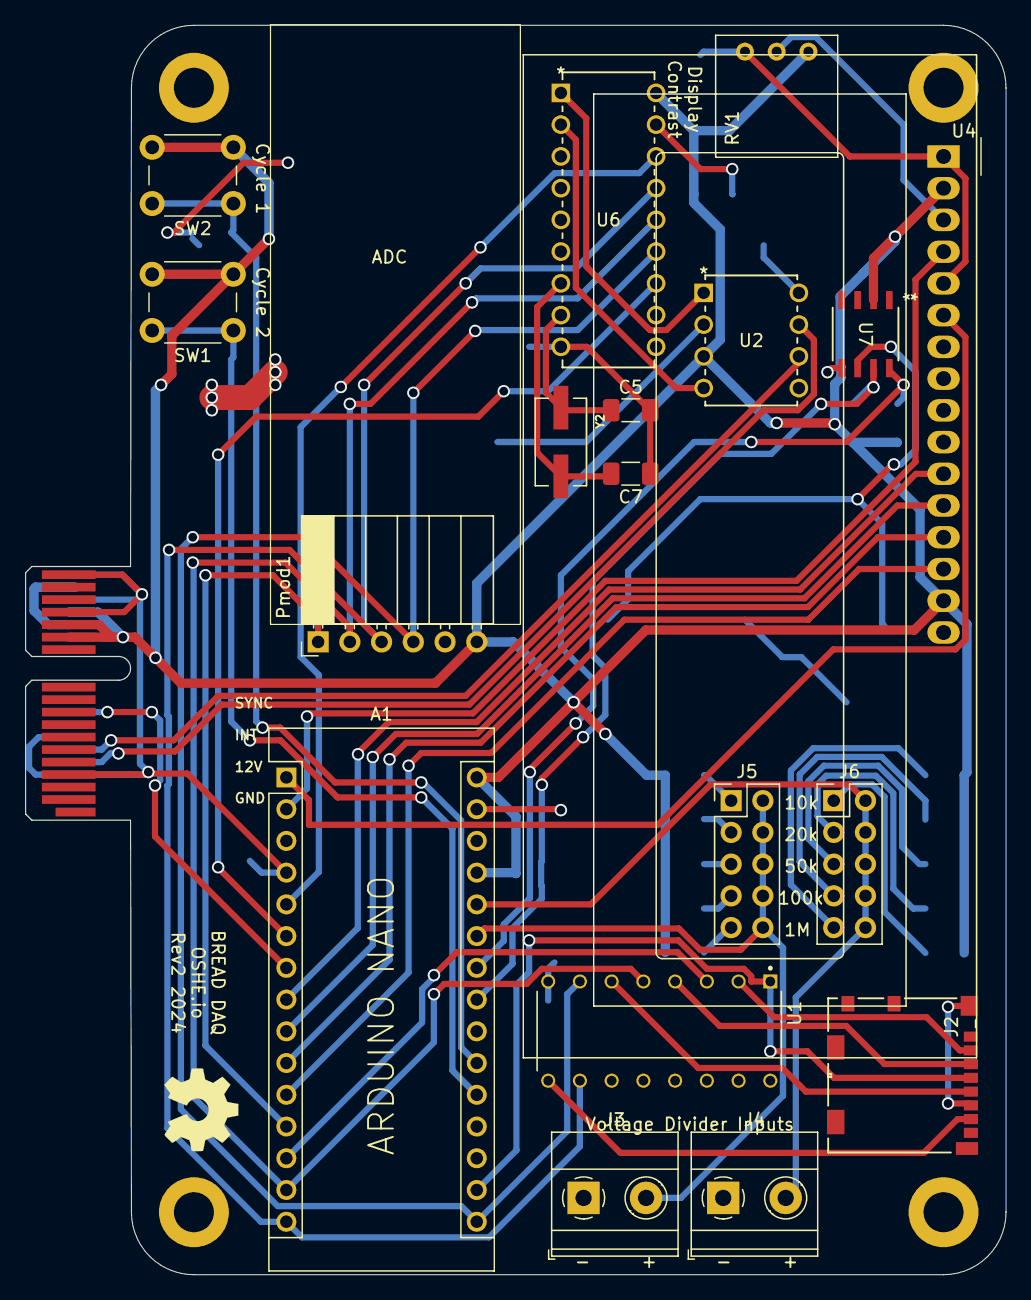
[picture p34: board DAQ Rev 2.kicad_pcb from above]

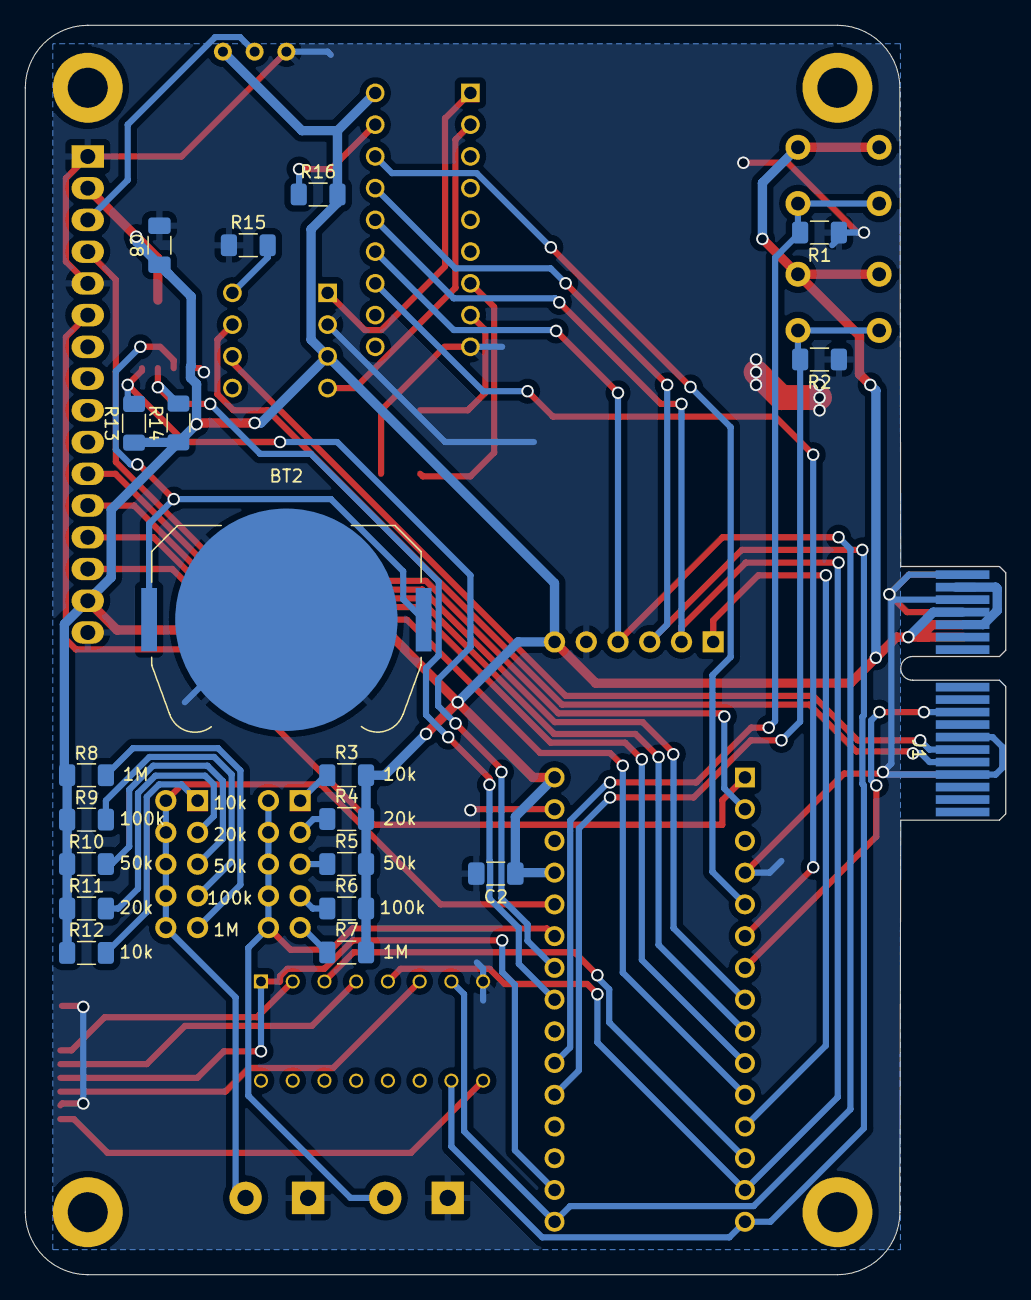
[picture p35: board DAQ Rev 2.kicad_pcb from below]

Board: 2 copper layers, 78.5 x 100.0 mm, 43 parts (20 on the bottom side), 47 nets.
