OSHE-Github/RecycleBot/PCB/BREAD_CAN Loaf/updated_LOAF.kicad_pcb

## KiCad design PCB/BREAD_CAN Loaf/updated_LOAF.kicad_pcb (2025-03-17)

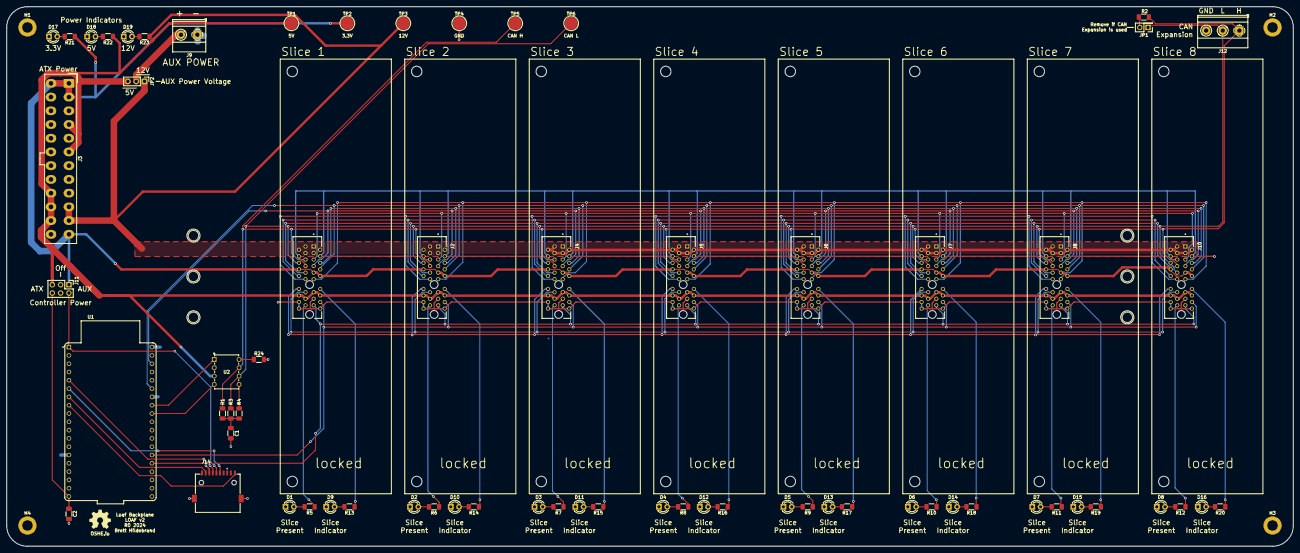
[picture p36: board updated_LOAF.kicad_pcb from above]

Board: 2 copper layers, 393.7 x 165.1 mm, 91 parts (0 on the bottom side), 66 nets.

Parts:
C1: 4700pF; C_1206_3216Metric_Pad1.33x1.80mm_HandSolder
C2: 10uF_t; C_1206_3216Metric_Pad1.33x1.80mm_HandSolder
D1, D2, D3, D4, D5, D6, D7, D8, D9, D10, D11, D12, D13, D14, D15, D16, D17, D18, D19: LED; LED_D3.0mm
DRA1, DRA2: DIN_Rail_Adapter; DINRailAdapter_3xM3_PhoenixContact_1201578
H1, H2, H3, H4: MountingHole; MountingHole_3.2mm_M3_DIN965_Pad
H5, H6, H7, H8, H9, H10, H11, H12, H13, H14, H15, H16, H17, H18, H19, H20: MountingHole; MountingHole_3.2mm_M3
J1, J2, J4, J5, J6, J7, J8, J10: 10018783-10200TLF; AMPHENOL_10018783-10200TLF
J3: ATX-24; Molex_Mini-Fit_Jr_5566-24A_2x12_P4.20mm_Vertical
J9: Screw_Terminal_01x02; TerminalBlock_Phoenix_MKDS-1,5-2_1x02_P5.00mm_Horizontal
J11: Conn_02x03_Odd_Even; PinHeader_2x03_P2.54mm_Vertical
J12: Screw_Terminal_01x03; TerminalBlock_Phoenix_MKDS-1,5-3-5.08_1x03_P5.08mm_Horizont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
J14: MSD-11-A; CUI_MSD-11-A
JP1: Jumper_2_Bridged; PinHeader_2x01_P2.54mm_Vertical
JP2: Jumper_3_Bridged12; PinHeader_1x03_P2.54mm_Vertical
Logo1: Logo_Open_Hardware_Small; OSHW-Symbol_6.7x6mm_SilkScreen
R1, R3: 60; R_1206_3216Metric_Pad1.30x1.75mm_HandSolder
R2: 120; R_1206_3216Metric_Pad1.30x1.75mm_HandSolder
R4: 300; R_1206_3216Metric_Pad1.30x1.75mm_HandSolder
R5, R6, R7, R8, R9, R10, R11, R12, R13, R14, R15, R16, R17, R18, R19, R20, R21, R22, R23: R_US; R_1206_3216Metric_Pad1.30x1.75mm_HandSolder
R24: 10k; R_1206_3216Metric_Pad1.30x1.75mm_HandSolder
TP1, TP2, TP3, TP4, TP5, TP6: TestPoint; TestPoint_Pad_D4.0mm
U1: ESP32-DEVKITC-32E; MODULE_ESP32-DEVKITC-32E
U2: MCP2561FD-E/P; PDIP8_300MC_MCH

Connections:
+3.3V: J1.A9, J1.A10, J1.B8, J2.A9, J2.A10, J2.B8, J3.1 (+3.3V), J3.2 (+3.3V), J3.12 (+3.3V), J3.13 (+3.3V), J4.A9, J4.A10, J4.B8, J5.A9, J5.A10, J5.B8, J6.A9, J6.A10, J6.B8, J7.A9, J7.A10, J7.B8, J8.A9, J8.A10, J8.B8, J10.A9, J10.A10, J10.B8, J11.1, R21.1, TP2.1
+5V: J1.A13, J1.A14, J1.B14, J1.B15, J2.A13, J2.A14, J2.B14, J2.B15, J3.4 (+5V), J3.6 (+5V), J3.21 (+5V), J3.22 (+5V), J3.23 (+5V), J4.A13, J4.A14, J4.B14, J4.B15, J5.A13, J5.A14, J5.B14, J5.B15, J6.A13, J6.A14, J6.B14, J6.B15, J7.A13, J7.A14, J7.B14, J7.B15, J8.A13, J8.A14, J8.B14, J8.B15, J10.A13, J10.A14, J10.B14, J10.B15, J11.5, JP2.3 (B), R22.1, TP1.1, U2.3 (VDD)
+12V: J1.A1, J1.A2, J1.A3, J1.B1, J1.B2, J1.B3, J2.A1, J2.A2, J2.A3, J2.B1, J2.B2, J2.B3, J3.10 (+12V), J3.11 (+12V), J4.A1, J4.A2, J4.A3, J4.B1, J4.B2, J4.B3, J5.A1, J5.A2, J5.A3, J5.B1, J5.B2, J5.B3, J6.A1, J6.A2, J6.A3, J6.B1, J6.B2, J6.B3, J7.A1, J7.A2, J7.A3, J7.B1, J7.B2, J7.B3, J8.A1, J8.A2, J8.A3, J8.B1, J8.B2, J8.B3, J10.A1, J10.A2, J10.A3, J10.B1, J10.B2, J10.B3, JP2.1 (A), R23.1, TP3.1
/CANH: J1.B5, J2.B5, J4.B5, J5.B5, J6.B5, J7.B5, J8.B5, J10.B5, J12.1, R1.1, R2.1, TP5.1, U2.7 (CANH)
/CANL: J1.B6, J2.B6, J4.B6, J5.B6, J6.B6, J7.B6, J8.B6, J10.B6, J12.2, JP1.1 (A), R3.2, TP6.1, U2.6 (CANL)
/EstpCh1: J1.A16, J2.A16, J4.A16, J5.A16, J6.A16, J7.A16, J8.A16, J10.A16, U1.J3_14 (IO0)
/EstpCh2: J1.A17, J2.A17, J4.A17, J5.A17, J6.A17, J7.A17, J8.A17, J10.A17, U1.J3_15 (IO2)
/RX: U1.J3_9 (IO18), U2.4 (RXD)
/SCL: J1.A7, J2.A7, J4.A7, J5.A7, J6.A7, J7.A7, J8.A7, J10.A7, U1.J3_3 (IO22)
/SDA: J1.A8, J2.A8, J4.A8, J5.A8, J6.A8, J7.A8, J8.A8, J10.A8, U1.J3_6 (IO21)
/SPLIT: R4.1, U2.5 (SPLIT)
/STBY: R24.1, U2.8 (STBY)
/SYNC: J1.B9, J2.B9, J4.B9, J5.B9, J6.B9, J7.B9, J8.B9, J10.B9
/Spare1: J1.B10, J2.B10, J4.B10, J5.B10, J6.B10, J7.B10, J8.B10, J10.B10
/Spare2: J1.B11, J2.B11, J4.B11, J5.B11, J6.B11, J7.B11, J8.B11, J10.B11
/Spare3: J1.B12, J2.B12, J4.B12, J5.B12, J6.B12, J7.B12, J8.B12, J10.B12
/Spare4: J1.B13, J2.B13, J4.B13, J5.B13, J6.B13, J7.B13, J8.B13, J10.B13
/Spare5: J1.A5, J2.A5, J4.A5, J5.A5, J6.A5, J7.A5, J8.A5, J10.A5
/Spare6: J1.A6, J2.A6, J4.A6, J5.A6, J6.A6, J7.A6, J8.A6, J10.A6
/Spare7: J1.A11, J2.A11, J4.A11, J5.A11, J6.A11, J7.A11, J8.A11, J10.A11
/TX: U1.J3_8 (IO19), U2.1 (TXD)
CLK: J14.P5 (CLK), U1.J2_5 (IO34)
CS: J14.CD, U1.J2_8 (IO33)
ESP 3V3: J11.2, J14.P4 (VDD), U1.J2_1 (3V3)
ESP 5V: C2.1, J11.6, U1.J2_19 (EXT_5V)
GND: C1.2, C2.2, D1.1 (K), D2.1 (K), D3.1 (K), D4.1 (K), D5.1 (K), D6.1 (K), D7.1 (K), D8.1 (K), D9.1 (K), D10.1 (K), D11.1 (K), D12.1 (K), D13.1 (K), D14.1 (K), D15.1 (K), D16.1 (K), D17.1 (K), D18.1 (K), D19.1 (K), J1.A4, J1.A15, J1.A18, J1.B4, J1.B7, J1.B16, J1.B18, J2.A4, J2.A15, J2.A18, J2.B4, J2.B7, J2.B16, J2.B18, J3.3 (GND), J3.5 (GND), J3.7 (GND), J3.15 (GND), J3.17 (GND), J3.18 (GND), J3.19 (GND), J3.24 (GND), J4.A4, J4.A15, J4.A18, J4.B4, J4.B7, J4.B16, J4.B18, J5.A4, J5.A15, J5.A18, J5.B4, J5.B7, J5.B16, J5.B18, J6.A4, J6.A15, J6.A18, J6.B4, J6.B7, J6.B16, J6.B18, J7.A4, J7.A15, J7.A18, J7.B4, J7.B7, J7.B16, J7.B18, J8.A4, J8.A15, J8.A18, J8.B4, J8.B7, J8.B16, J8.B18, J9.1, J10.A4, J10.A15, J10.A18, J10.B4, J10.B7, J10.B16, J10.B18, J12.3, J14.G1 (COVER_GND), J14.G2 (COVER_GND__1), J14.P6 (VSS), R24.2, TP4.1, U1.J2_14 (GND_J2_14), U1.J3_1 (GND_J3_1), U1.J3_7 (GND_J3_7), U2.2 (VSS)
MISO: J14.P7 (DAT0), U1.J2_7 (IO32)
MOSI: J14.P3 (CMD), U1.J2_6 (IO35)
unnamed: C1.1, R1.2, R3.1, R4.2
unnamed: D1.2 (A), R5.2
unnamed: D2.2 (A), R6.2
unnamed: D3.2 (A), R7.2
unnamed: D4.2 (A), R8.2
unnamed: D5.2 (A), R9.2
unnamed: D6.2 (A), R10.2
unnamed: D7.2 (A), R11.2
unnamed: D8.2 (A), R12.2
unnamed: D9.2 (A), R13.2
unnamed: D10.2 (A), R14.2
unnamed: D11.2 (A), R15.2
unnamed: D12.2 (A), R16.2
unnamed: D13.2 (A), R17.2
unnamed: D14.2 (A), R18.2
unnamed: D15.2 (A), R19.2
unnamed: D16.2 (A), R20.2
unnamed: D17.2 (A), R21.2
unnamed: D18.2 (A), R22.2
unnamed: D19.2 (A), R23.2
unnamed: J9.2, JP2.2 (C)
unnamed: JP1.2 (B), R2.2
Sl1Lt: J1.A12, R13.1
Sl1Prs: J1.B17, R5.1
Sl2Lt: J2.A12, R14.1
Sl2Prs: J2.B17, R6.1
Sl3Lt: J4.A12, R15.1
Sl3Prs: J4.B17, R7.1
Sl4Lt: J5.A12, R16.1
Sl4Prs: J5.B17, R8.1
Sl5Lt: J6.A12, R17.1
Sl5Prs: J6.B17, R9.1
Sl6Lt: J7.A12, R18.1
Sl6Prs: J7.B17, R10.1
Sl7Lt: J8.A12, R19.1
Sl7Prs: J8.B17, R11.1
Sl8Lt: J10.A12, R20.1
Sl8Prs: J10.B17, R12.1
