OSHE-Github/RecycleBot/(commit log)

2025-03-17 Added pictures of build from mid-spring 2025
2025-03-17 Migrated PCB and Firmware files to this repo
    [10018783-10200TLF.step, BC2032-E2.step, BREAD_Indicators.kicad_sch, BREAD_Power.kicad_sch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]
2025-03-27 fixed can tx/rx on input only pins
    [BREAD_slice_v2.kicad_pcb, BREAD_slice_v2.kicad_sch]
2025-03-31 finished? stepper slice
2025-03-31 support for stepper slice and infidel sensor on DAQ
2025-04-10 better tuned control loop to change speed sooner and increment by smaller steps to avoid over and undershooting target diameter
    [main.cpp]
2025-04-26 added 3d print files for rewind unit + others, added gitignore for kicad lock files
    [DriveShaft.stl, Infidel_Stand.stl, KYZ PASTA lite - 608 Bearing Fully Printed.stl(1).stl, KYZ PASTA lite - 608 Bearing Fully Printed.stl.stl, KYZ PASTA lite - Guide Housing.stl.stl, KYZ PASTA lite - Guide Pin.stl.stl, KYZ PASTA lite - Idler Fully Printed v2.stl(1).stl, KYZ PASTA lite - Idler Fully Printed v2.stl.stl]
